741-xiao/stm32f407-dual-board-ai/方案设计.md

# 实验七 · 技术方案设计（v1）

> 依据：《需求确认.md v1.0》（题0/1/2/3 验收条款已确认）。
> 一句话目标：**两块 STM32F407** —— 板1 采集并本地显示，经 **CAN** 广播给板2（双屏显示 + **两板都呼吸灯**）；
> 两块板各自把本板 5 项数据经 **WiFi** 上报 PC，入库 MySQL，**网页 2 页**呈现；
> 再用 **CUBE-AI 神经网络**（跑在 STM32 上）判定"这条数据来自哪块板"。
>
> **姓名：郑鑫　　学号：202440700111**
>
> 当前状态：`firmware/` 为实验六工程拷贝，Keil Target 已收敛为 **board1/board2**（两 Target 0E0W）。
> 本方案描述从实验六到实验七的完整改造路径，其中 **§7 神经网络是本实验的主体新增**。

---

## 1. 总体策略

| 层 | 策略 | 理由 |
|---|---|---|
| 工程 | **独立仓库 `Lab7/`**，从实验六拷贝，收敛为两块板 | 实验六保持原样可交付，两者互不干扰 |
| 应用层 | 沿用一份共享实现（`app_node.c`），差异用 `BOARD_SEL`(1/2) 分叉 | 两块板硬件相同、功能高度重合 |
| 板间层 | **沿用 CAN1**（板1 广播数据/控制 → 板2 收） | 题目指定 can/485，CAN 实验六已跑通 |
| 网络层 | 两块板**都是 TCP client** → PC:8080 | 板间数据由 CAN 承担，WiFi 只上报 PC |
| 协议 | WiFi 侧升级 **v7**：D 帧追加 AI 判定字段；新增 **S 状态帧**（采集启停） | 题1 要求网页显示"采集开始/停止"；题2 要在页面显示 AI 结果 |
| PC 端 | 单文件上位机 → **拆成 2 页**（列表页 / 图形页） | 题1 明确"分 2 页" |
| 数据库 | `stm32_lab` 库新建 **`lab7_data`** 表 | 与实验四/五/六 数据互不干扰 |
| **AI** | **PC 训练（Keras）→ X-CUBE-AI 转 C → 板上推理** | 贴题给定路线（CSDN 那篇的操作方法） |

---

## 2. 系统拓扑

```
              PC（移动热点 192.168.137.1）
              ├── 上位机 TCP:8080（收两块板）
              ├── MySQL  stm32_lab.lab7_data
              └── 网页 2 页：① 记录列表（分页）  ② 图形（多风格）
      ▲                        ▲
      │WiFi client              │WiFi client
 ┌────┴────┐              ┌────┴────┐
 │  板1    │              │  板2    │
 │ 主控    │              │ 从节点  │
 │ +AI推理 │              │ +AI推理 │
 └────┬────┘              └────┬────┘
      └──── CAN 总线（双绞线，两端 120Ω）────┘
        板1 广播数据/控制 → 板2 接收
        板2 回传本板原始值 → 板1 做 AI 交叉验证（§7.6）
```

- **CAN**：两节点挂一对差分线（CANH/CANL），两端 120Ω，**必须共地**。
- **WiFi**：两块板各自 STA 连 PC 热点，静态 IP `192.168.137.51`（板1）/ `.50`（板2）。
- **两网分离**：板间走 CAN、上报走 WiFi，互不耦合。

---

## 3. CAN 通信设计

### 3.1 物理层与配置

| 项 | 取值 | 说明 |
|---|---|---|
| 外设 | **CAN1**（F407 原生） | 由 CubeMX 生成 `Core/Src/can.c`（MX_CAN1_Init / hcan1） |
| 引脚 | **PA11 = CAN1_RX，PA12 = CAN1_TX**（AF9） | ★ **不能用 PD0/PD1**（被 FSMC 占用，是 LCD 数据线 D2/D3） |
| 速率 | **500 kbps** | Prescaler=6、Seg1=10 tq、Seg2=3 tq（APB1=42MHz） |
| 帧格式 | 标准帧（11 位 ID），DLC ≤ 8 | 两节点广播，无需扩展帧 |
| 收发器 | 板载 **TJA1050**（U9） | 见 `docs/硬件核对-原理图.md` |
| 收发方式 | FIFO0 + 轮询（不加中断） | 1Hz 数据率，`CanTask` 每 10ms 取帧足够 |

> ★★ **上板前必做**：短接 **P21**（2×3 排针）的 **3–5 和 4–6**。
> PA11/PA12 与 USB 座共用，P21 是 USB/CAN 二选一。不跳 =
> 程序全对但**总线上毫无波形**（最容易被误判成"程序坏了"）。
> ★ 不要再外接 120Ω：每板自带一个（R35），两块板并联 ≈60Ω，短母线正合适。

### 3.2 报文定义

| ID | 名称 | 方向 | DLC | 载荷（大端） | 周期 |
|---|---|---|---|---|---|
| `0x100` | **DATA_A** | 板1→板2 | 8 | `seq(2) t10(2) h10(2) light(2)` | 1 Hz |
| `0x101` | **DATA_B** | 板1→板2 | 8 | `eco2(2) tvoc(2) status(1) board(1) rsv(2)` | 1 Hz |
| `0x200` | **CTRL** | 板1→板2 | 1 | `0x01=START / 0x00=STOP` | 事件 |
| `0x180` | **HEARTBEAT** | 双向 | 1 | `board` | 1 Hz |
| `0x110` | **PEER_A** | **板2→板1** | 8 | `seq(2) t10(2) h10(2) light(2)` | 1 Hz |
| `0x111` | **PEER_B** | **板2→板1** | 8 | `eco2(2) tvoc(2) status(1) board(1) rsv(2)` | 1 Hz |

- **量纲**：`t10/h10` = ×10 有符号（可负温）；`light` 0..4095；`eco2` ppm；`tvoc` ppb；`status` `1=OK/0=ALM`。
- **★ 新增 `0x110/0x111`（板2 → 板1）**：实验六是单向广播（板1 只发、板2/3 只收）。
  实验七题2 要做 **AI 交叉验证**（§7.6）—— 板1 必须拿到**板2 的原始 5 项值**，
  才能用自己那份模型去判"这条数据来自哪块板"。因此增加反向数据帧，**只加收，不改原有语义**。
- **在线判定**：板2 若 3s 未收到任一 `0x1xx` → 判板1 离线（「板1 区」占位"未连接"）；
  板1 若 3s 未收到 `0x180` 心跳 → 判板2 离线（状态页 `SLAVE2` 显示 NO）。

> 为什么数据拆两帧：5 项数值（2+2+2+2+2=10 字节）超过 CAN 单帧 8 字节上限，
> 按"序号+温湿光 / CO2+TVOC+状态"拆最清晰。

### 3.3 CAN 驱动接口（`USER/CAN/can_link.c`）

```c
u8   Can_Init(void);                       /* 配滤波器 + 进 Normal（★ 内部不调 HAL_CAN_Start，见下） */
u8   Can_SendData(s16 t10, s16 h10, u16 light, u16 eco2, u16 tvoc,
                  u16 seq, u8 ok, u8 board);          /* 按 board 自动选 0x100/0x101 或 0x110/0x111 */
u8   Can_SendCtrl(u8 start);                          /* 1=START / 0=STOP */
u8   Can_SendHeartbeat(u8 board);
u8   Can_Recv(can_msg_t *out);                        /* 非阻塞取一帧（FIFO0），1=取到 */
```

> ★★ **`Can_Init()` 故意不调 `HAL_CAN_Start()`**：它内部 `while` 等 INAK 清零，
> 唯一出口是 `HAL_GetTick()` 超时；本工程 HAL 时基从 SysTick 挪到了 TIM6，
> 而 `uwTick` 在那种场景下不涨 ⇒ **死循环**（实验六板2 白屏的根因）。
> 现在直接清 `INRQ` + 置 `LISTENING`，硬件同步上总线后自动进 Normal。

---

## 4. 网络方案与协议 v7

### 4.1 拓扑与 IP

| 节点 | 角色 | 静态 IP | 目标 |
|---|---|---|---|
| 板1 | STA / client | `192.168.137.51` | TCP → PC:8080 |
| 板2 | STA / client | `192.168.137.50` | TCP → PC:8080 |

- 两块板 AT 流程一致：`CWMODE=1 → CWJAP → CIPSTA=静态IP → CIPMUX=1 → CIPSTART=0,TCP,PC,8080 → READY`
- **断线重连**（实验六已修定，沿用）：三条通路 ——
  ① 模块吐 `0,CLOSED` → 标记 + 单发 `AT+CIPSTART`；② `CIPSEND` 失败兜底（半开连接）；
  ③ 周期补连（开机时 PC 没开）。PC 补连间隔 **5s**（`PC_RETRY_MS = LINK_RETRY_MS`）。
- ★ 补连成功回 READY 时**必须 `px_reset()`**（三处复位点要齐，否则 `+IPD` 状态机吃帧）。

### 4.2 协议 v7（WiFi 侧，相对实验六 v6 的变化）

| 类型 | v6（实验六） | v7（实验七） | 方向 |
|---|---|---|---|
| H 握手 | `H,<名>,<学号>,<board>` | 不变（★ **板号在最后一个字段**） | 板→PC |
| D 数据 | `D,<board>,<up_ms>,<seq>,<t>,<h>,<light>,<eco2>,<tvoc>,<OK/ALM>` | **追加 AI 判定**：`...,<ai_cls>,<ai_conf>` | 板→PC |
| **S 状态** | — | **新增** `S,<board>,START/STOP` | **板→PC** |
| — | （C 控制帧在实验六已删除） | 板间控制走 CAN，PC 仍不控制板 | — |

示例：

```
D,2,123456,0007,26.1,58.2,3210,512,23,OK,2,96      ← AI 判为板2，置信度 96%
S,1,START                                          ← 板1 开始采集
S,1,STOP                                           ← 板1 停止采集
```

- `ai_cls`：0 = 未推理 / 1 = 判为板1 / 2 = 判为板2
- `ai_conf`：0..100（百分比，四舍五入）
- **S 帧发送时机**：`running` 状态**发生变化**时立刻发一次（外加首次连上补发一次当前状态），
  保证网页打开时就能看到当前是"采集开始"还是"停止"。

### 4.3 空口流量预算

| | 实验六（三板） | 实验七（两板） |
|---|---|---|
| 每板发送 | 1 帧/s（D 帧 → PC） | 1 帧/s（D 帧）+ 偶发 S 帧 |
| 合计 | ~3 帧/s | **~2 帧/s** |

实验五实测单模块约 2 帧/s 时负载 20~60%。**2 帧/s 总负载更低，1Hz 采样安全**。

---

## 5. 固件设计

### 5.1 相对实验六的改动点

| 文件 | 动作 | 说明 |
|---|---|---|
| `USER/LED/led_effect.c` | **改** | ★ **板1 从流水灯改为呼吸灯**（题1："两板 LED 灯进行呼吸灯功能"）—— 两板统一走 TIM7 软 PWM |
| `USER/App/app_node.c` | 改 | ① 采集启停变化时发 **S 帧**给 PC；② 两板收敛（去掉 板3 相关显示/在线逻辑）；③ AI 推理任务与判定字段 |
| `USER/CAN/can_link.c/.h` | 改 | 新增 `0x110/0x111`（板2→板1）收发；`Can_SendData` 按 board 选 ID |
| `USER/AI/` | **新增** | X-CUBE-AI 生成的模型代码（`ai_*.c/.h`、`*-data-*` 权重表）+ 一层薄封装 `ai_model.c/.h` |
| `tools/make_project.py` | 改 | `USER_FILES` 挂入 AI 源文件；`USER_INC` 加 `../USER/AI` |
| `pc/upper_computer.py` | 改 | 拆 2 页；解析 S 帧与 AI 字段；入库加 ai 两列 |
| `pc/init_db.sql` | 改 | 新建 `lab7_data` 表 |

### 5.2 任务划分（两块板相同）

| 任务 | 优先级 | 周期 | 独占资源 | 职责 |
|---|---|---|---|---|
| `KeyTask` | 5 | 10ms | PF6~9 | 扫描按键（板1 作主控；板2 仅调试） |
| `SensorTask` | 4 | 1s | I2C1(SHT30)+I2C2(SGP30)+ADC1 | 采集 5 项 → 状态 + 样本队列 |
| `CanTask` | 3 | 10ms | CAN1 | 板1：广播数据/控制 + 收板2 回传；板2：收帧解析 + 回传本板值 |
| `WifiTask` | 3 | 5ms | UART4 | 推状态机 + 出队 → 组 D/S 帧 → 上报 PC |
| `AiTask` | **2** | 1s | （只读状态 + 少量 CPU） | **读最新样本 → 归一化 → `ai_run()` → 写判定结果** |
| `LedTask` | 2 | 20ms | LED 效果状态 | 推呼吸亮度 |
| `DisplayTask` | 2 | 200ms | FSMC(LCD) | 读状态刷屏 |
| `DebugTask` | 1 | 20ms | USART1 | 串口命令台（含 AI 判定打印） |

> `AiTask` 单独建一个任务（而不是塞进 `SensorTask`）的理由：推理有确定的最坏耗时，
> 放在采集任务里会把 1Hz 采样周期的抖动放大；单独建任务可独立测量耗时、独立降频。

### 5.3 按键 → 行为联动表

| 事件 | 板1 动作 | CAN 报文 | 板2 收到后 | 上报 PC |
|---|---|---|---|---|
| **板1 KEY0（按键1）** | `running=1`，开始采集 | `0x200 [0x01]` | 「板1区」开 → 呼吸灯开 | **`S,1,START`** |
| **板1 KEY1（按键2）** | `running=0`，报警解除 | `0x200 [0x00]` | 「板1区」清空 + 呼吸灯灭 | **`S,1,STOP`** |
| 板1 采集周期 | 出队样本 → D 帧上报 | `0x100+0x101`（1Hz） | 更新「板1区」数值 | D 帧 |
| **板2 上电** | 自动 `running=1`（上电即采） | `0x110+0x111`（1Hz 回传） | 显示本板区 | D 帧 + `S,2,START` |
| 板1 KEY2 / KEY3 | 切显示页 / 手动重发 CAN 快照 | — | 同左（KEY3 改为恢复 I2C） | — |

### 5.4 LED 效果（★ 相对实验六的改动）

| 板 | 实验六 | 实验七 |
|---|---|---|
| 板1 | 流水灯（三灯轮转 300ms） | **呼吸灯**（三灯同步，TIM7 软 PWM） |
| 板2 | 呼吸灯 | 呼吸灯（不变） |

- 触发：板1 = `running`（本板采集开关）；板2 = 收到 CAN `CTRL START`。
- **上电初始不亮**（实验六已如此）：符合"按板1按键1 才点亮两板 LED"的验收口径。

### 5.5 LCD 布局（沿用实验六，行距 28）

- **板1**：本板 5 项 + 序号/状态 + CAN 在线 + 底栏（WiFi/消息/按键提示）
- **板2**：本行 0 =「本板」小标题，数据在行 1..5；行 6..11 = 「板1区」+ 状态
- ★ **行号纪律**：本板 5 项数据的首行必须用 `OWN_ROW0` 宏（板1 → 0，板2 → 1），
  曾写死 0..4 导致从机页整列数值上移一行。
- ★ **擦除纪律**：静态骨架只画不擦；擦除只发生在动态字段自己的矩形内，
  且按**最宽的那个内容**先擦后画（同一位子轮换 `--` / 数值 / `关闭` 时）。

---

## 6. PC 上位机设计（2 页）

### 6.1 接收侧

- TCP 8080 收**两条连接**（板1/2），一连接一线程；身份靠 H/D/S 帧的 board 字段识别。
- 每块板各自标定 `offset`，换算 `sample_time`。
- 入库带 `board + 5 项 + ai_cls + ai_conf`；无口令/无 pymysql 时降级（只收不发库）。
- ★ **H 帧板号在最后一个字段**（`p[3]`）；D/S 帧板号在 `p[1]`。

### 6.2 页面结构（题1 明确"分 2 页"）

| 页面 | 路径 | 内容 |
|---|---|---|
| **① 记录列表页** | `/` | 状态条（**采集进行中 / 已停止**，由 S 帧驱动）+ 实时列表 + **分页**（首/上/下/末页、每页条数可选）+ 筛选/排序/编辑/删除/导出 CSV |
| **② 图形页** | `/chart` | **不同风格的图**：折线 / 柱状 / 面积（+ 散点或饼图凑"多种风格"），每图区分板1/板2 |

- 两页顶部**互相导航**（列表页 ↔ 图形页）。
- 「区分两板与采集时间」：列表每行标注**板号徽标**（板1 蓝 `#378ADD` / 板2 橙 `#EF9F27`，沿用实验六配色）与**采集时间**（毫秒精度）。
- 「显示采集开始/停止」：状态条由最新 S 帧决定；**超时兜底**（比如 10s 没收到该板任何帧 → 显示"离线"）。

### 6.3 MySQL 新表（`pc/init_db.sql`）

```sql
CREATE TABLE IF NOT EXISTS lab7_data (
    id          BIGINT UNSIGNED   NOT NULL AUTO_INCREMENT PRIMARY KEY,
    board       TINYINT UNSIGNED  NOT NULL COMMENT '1=板1，2=板2',
    seq         INT UNSIGNED      NULL,
    temp        DECIMAL(4,1)      NULL COMMENT '温度 ℃',
    humi        DECIMAL(4,1)      NULL COMMENT '湿度 %RH',
    light       SMALLINT UNSIGNED NULL COMMENT '光敏 AO 原始值 0..4095',
    eco2        INT UNSIGNED      NULL COMMENT 'SGP30 eCO2，ppm',
    tvoc        INT UNSIGNED      NULL COMMENT 'SGP30 TVOC，ppb（教材作"甲醛"指标）',
    status      VARCHAR(8)        NULL COMMENT 'OK / ALM',
    ai_cls      TINYINT UNSIGNED  NULL COMMENT 'AI 判定：0=未推理 1=板1 2=板2',
    ai_conf     TINYINT UNSIGNED  NULL COMMENT 'AI 置信度 0..100',
    up_ms       INT UNSIGNED      NULL COMMENT '该板 up_ms',
    sample_time DATETIME(3)       NULL COMMENT '采集时间（PC 换算）',
    recv_time   DATETIME(3)       NULL COMMENT 'PC 接收时间',
    KEY idx_board_sample (board, sample_time)
) ENGINE=InnoDB DEFAULT CHARSET=utf8mb4 COLLATE=utf8mb4_unicode_ci
  COMMENT='实验七 两板 温湿度+光敏+eCO2+TVOC + AI判定';
```

---

## 7. 神经网络方案（★ 本实验主体新增）

### 7.1 任务定义

| 项 | 取值 |
|---|---|
| 输入 | 5 维：`temp(℃) / humi(%RH) / light(0..4095) / eco2(ppm) / tvoc(ppb)` |
| 输出 | **2 分类**：`板1` / `板2`（softmax 两个概率） |
| 训练数据 | 两板**各 ≥ 100 条**已入库记录（题2 明确"至少各 100 条以上"） |
| 推理位置 | **STM32 板上**（X-CUBE-AI 生成的 C，`ai_run()`） |
| 题面"哪个传感器" | 落为**主导传感器特征**：给出各输入通道对判定的贡献（见 §7.5），串口/页面一并显示 |

> **为什么不做"10 类（板号×传感器）"**：一条记录本来就是 5 个传感器**同时**采的，
> "是哪个传感器采集数据"无法构成互斥标签。已确认按"判板号 + 输出主导特征"落地
> （见《需求确认.md》第六节决定 2）。

### 7.2 ★ 前置：可分性检验（决定题2 成败，务必先做）

**风险**：两板放同一张桌子上时，同型号传感器读数分布几乎重合，
神经网络只能学到比值 ≈ 随机 —— 训完才发现就晚了。

**做法**：采集完成后先跑 `tools/check_separability.py`：

1. 两板各 ≥100 条 → 合并成带 `board` 标签的数据集；
2. **5 折交叉验证**（用轻量分类器，如逻辑回归/随机森林）给出准确率；
3. **通道分布对比**：逐通道画两板的直方图 / 箱线图，看差异落在哪个通道；
4. **PCA / 二维投影散点图**：直观看出两簇是否分离；
5. 输出结论：**准确率 ≥ 80% 视为可分**，可以进入训练；否则先调整摆放重采。

**"制造可分性"的合规做法**（不是造假，是让两板处于可区分的真实工况）：

- 板1 放在**常温区**（如桌面），板2 放在**另一处**（靠窗 / 靠散热口 / 用手捂或遮光）；
- 让两板的**光照条件**不同（一块朝窗、一块背光）—— 光敏通道差异最显著；
- 让两板附近**CO₂/TVOC 环境**不同（一块靠近人呼吸方向）—— SGP30 通道差异；
- 另外每片传感器本身有**器件个体偏差**与 ADC 通道偏移，这部分差异是稳定的、可学的。

> 检验脚本会把"哪些通道在起区分作用"直接打印出来，正好作为 §7.5
> "主导传感器特征"的**物理解释依据**，一举两得。

### 7.3 训练流程（`tools/train_nn.py`）

```
MySQL lab7_data
   ↓ 导出 CSV（仅取 status='OK' 的行，剔除预热期与异常值）
特征工程
   ↓ z-score 标准化：mean/std 由训练集算出，★ 并存成 .h 供固件复用
模型（小 MLP，够小才塞得进 F407）
   ↓ 5 → 16 (ReLU) → 16 (ReLU) → 2 (Softmax)
训练
   ↓ Adam，交叉熵，batch 16，早停（验证集）；训练:验证 = 8:2，分层抽样
评估
   ↓ 混淆矩阵 / 准确率 / 每类精确率召回率
导出
   ↓ 保存 model.keras（或 .h5）
X-CUBE-AI
   ↓ analyze → generate（生成 C 代码 + 内存报告）
固件
   ↓ ai_<model>_create / init / run
```

**参数量估算**（决定 F407 是否吃得下）：

| 层 | 参数 |
|---|---|
| 5 → 16 | 5×16 + 16 = 96 |
| 16 → 16 | 16×16 + 16 = 272 |
| 16 → 2 | 16×2 + 2 = 34 |
| **合计** | **402 参数** ≈ 1.6 KB（float32） |

F407 带**单精度 FPU**，这个规模即使不量化也毫无压力；
若想演示量化收益，可另跑一次 int8（体积 ~0.4 KB，但需注意输入量化）。

> ★ **归一化必须一致**：板上推理时要用**训练时同一套 mean/std**。
> 所以训练脚本除了模型，还要导出 `ai_norm.h`（5 个 mean + 5 个 std），
> 固件里在喂给 `ai_run()` 之前做同样的 z-score。
> 这是"PC 训练 / 板上推理"最容易出错的一环 —— 忘了这步会得到完全离谱的判定。

### 7.4 集成进 Keil 工程

| 步骤 | 做法 |
|---|---|
| 1 | 用户先完成**题0**：CubeMX 里装好 X-CUBE-AI（ST 账号登录 → [STMicroelectronics] → [X-CUBE-AI] → Install） |
| 2 | 用 X-CUBE-AI 分析 `model.keras`（CubeMX 图形界面，或 `stm32ai analyze`） |
| 3 | 生成 C 代码（一般落在 `firmware/X-CUBE-AI/App/` 或指定目录），把生成物搬进 `firmware/USER/AI/` |
| 4 | 跑 `python tools/make_project.py firmware` 重新挂文件 + include 路径（**不要手工改 XML**） |
| 5 | 两 Target 编译 0E0W，检查 Flash/RAM 增量（`Program Size` 行 + X-CUBE-AI 的内存报告） |

> ★ CubeMX 重新生成工程后**必做两件事**：① 跑 `make_project.py`（恢复 USER 组与两个 Target）；
> ② 确认 startup 的 `Stack_Size` 仍是 `0x1000`。

### 7.5 「主导传感器特征」怎么给

三种做法，按实现成本递增（先做第 1 种，够用即可）：

1. **单通道扰动法（最直接）**：把一条样本的某个通道替换成另一板的均值，看输出概率变化多少。
   变化越大 → 该通道越"主导"。5 个通道各做一次，取 Top-2 显示。
2. **输入梯度 / 显著性**：\|∂输出/∂输入\| 归一化后排序（板上算成本高，适合 PC 侧算完展示）。
3. **消融重训**：逐个通道去掉重训，看准确率掉多少（慢，但最有说服力，可放文档里当补充实验）。

> 落地产出：串口/页面显示形如
> `AI 判定: 板2 (96%)  主导特征: light, eco2`
> —— 这既回应了题面"是哪个传感器采集数据"，也解释了模型到底靠什么在做判别。

### 7.6 ★ CAN 交叉验证演示（题2 的亮点闭环）

```
板2 采集本板 5 项
   ↓ CAN 0x110 / 0x111（板2 → 板1）
板1 收到"对板原始值"
   ↓ 用板1 自己那份模型 + 同一套归一化参数 → ai_run()
板1 判定：这条数据来自 板2  ✔（串口 + 网页显示）
```

- 对照组：板1 拿**自己**的数据推理，应判为**板1**。
- 这样"AI 判来源"就不是纸面指标，而是**能当场演示**的闭环，且完全复用实验六那条 CAN 链路。
- 演示顺序（录进 KK 录像）：① 板1 判自己 → 板1；② 板1 判 CAN 传来的板2 数据 → 板2；
  ③ 网页上同时可见两板的 AI 判定与置信度。

---

## 8. 实施阶段计划（里程碑）

| 阶段 | 内容 | 验证方式 | 状态 |
|---|---|---|---|
| **0** | 骨架（实验六拷贝 + 两 Target 收敛）+ 需求确认 + 本方案 | 两 Target 0E0W；文档提交 | ✅ 已完成 |
| 1 | 题1 改造：板1 呼吸灯；采集启停上报 PC（S 帧） | 上板看两板呼吸；网页状态条随按键变化 | ⬜ |
| 2 | 题1 改造：上位机拆 2 页 + MySQL 真跑通（`lab7_data`） | 两页可导航；库中数据可查 | ⬜ |
| 3 | 题2 数据采集：两板各 ≥100 条 | `check_separability.py` 输出可分性结论 | ⬜ |
| 4 | 题2 训练 + X-CUBE-AI 转换 + 集成 | 模型报告（准确率/Flash/RAM）；两 Target 0E0W | ⬜ |
| 5 | 题2 板上推理 + 串口/页面上报 + CAN 交叉验证 | 任取 10 条，串口逐条输出判定与对错 | ⬜ |
| 6 | 题3 文档（≥3 页含截图）+ KK 录像 | 照 §9 验收脚本逐条走 | ⬜ |
| 7 | 全链路验收 | 对照《需求确认.md》A/B/C/D/G/H 逐条 | ⬜ |

> 实施纪律（沿用实验五/六）：每步"改动 → 编译 0E0W → 上板 → git commit（message 中文带阶段号）"。
> `Core/` 下 CubeMX 生成代码不手改（CAN 初始化属手写例外，已加注释说明）。

---

## 9. 风险与备选

| # | 风险 | 缓解 | 备选 |
|---|---|---|---|
| 1 | **两板数据不可分**（题2 最大风险） | §7.2 先做可分性检验；按需调整两板摆放制造稳定差异 | 加大环境差异（热源/遮光/CO₂ 源）；或增加派生特征 |
| 2 | X-CUBE-AI 未安装 / 装不上 | 题0 需 ST 账号联网安装；提前确认 CubeMX ≥6.9 | 用 `stm32ai` 命令行单独生成 |
| 3 | CubeMX 重新生成把 Target 改名 | 生成后必跑 `make_project.py`（恢复 USER 组 + board1/2） | 保留 `firmware.uvprojx.pre_make.bak` 回溯 |
| 4 | AI 代码吃 Flash/RAM | 模型仅 402 参数（≈1.6KB）；X-CUBE-AI 会先给内存报告 | int8 量化；或缩小隐藏层 |
| 5 | **归一化参数不一致**导致板上判定离谱 | 训练脚本一并导出 `ai_norm.h`（mean/std），固件用同一套 | 干脆把归一化写进模型第一层（X-CUBE-AI 支持把归一化烘焙进网络） |
| 6 | CAN 没跳 P21 跳线 → 总线上无波形 | 上板清单里列为**必做项**，先量波形再查程序 | 用示波器看 PA12 是否有发送沿 |
| 7 | MySQL 口令/编码问题 | `pc/db_local.py` 本地私有（不入库），用 `utf8mb4` | 降级为只收不发库（不影响网页演示） |
| 8 | 单模块 2 帧/s 负荷 | 两块板各 1 帧/s，预算比实验六更宽 | 降采样到 0.5Hz |

---

## 10. git 版本管理

- 仓库：`E:/Develop/SignalsAndSystems/Lab7/`（**独立仓库**）。
- `.gitignore` 沿用实验六，并新增 AI 中间产物（`ai/dataset/*.csv`、`ai/model/*.h5|.keras|.tflite`）不入库
  —— 模型和数据都能用脚本重建，只把**生成它们的脚本**入库。
- 提交规划：① 初始骨架（实验六拷贝 + 两 Target）→ ② 需求确认 + 方案设计 → 后续每阶段一次提交，message 中文带阶段号。
