741-xiao/stm32f407-dual-board-ai/需求确认.md

# 实验七 · 需求确认（v1.0）

> 把题目原文整理为"可验收条款"，作为开发与验收基线。
> 2026-10-12 就 7 项关键问题达成确认（见第六节）。
>
> **姓名：郑鑫　　学号：202440700111**（各题交付物均需署名，见 `docs/` 内文档首页）

---

## 一、原始需求（题目原话）

**题 0（环境准备）**
> 在 stm32cubemx 安装好 x-cube-ai，stm32cubemx 版本至少 6.9 以上，并利用 st 账号登录，在 [STMicroelectronics] 标签页下找到 [X-CUBE-AI]，勾选需要的 Artificial Intelligence 版本，点 [Install]，按提示完成安装即可。

**题 1（两板采集 → 双屏显示 → 上传入库 → 网页显示）**
> 利用两块 STM32F407 开发板，通过 can 或 485 进行控制连接，在板1按键1将两板温湿度 SHT30、光敏、co2 甲醛传感器分别显示在各自 OLED 上，同时利用 wifi 上传到 PC 机 mysql 数据库中保存，利用 python 或 java 分 2 页完成动态列表分页显示记录和不同风格的图形，注意区分两板与采集时间，两板 LED 灯进行呼吸灯功能，板1按键2将停止采集，LED 灯停止，web 页面显示采集开始或停止。

**题 2（神经网络）**
> 对题1采集的两板传感器数据记录，至少各 100 条以上，利用 https://qingsong.blog.csdn.net/article/details/130823175 （我在STM32单片机上跑神经网络算法—CUBE-AI）操作方法，利用神经网络方法进行训练，在后续采集的数据中进行检测，任取10条记录，能否在串口/页面中判定是哪个开发板数据，是哪个传感器采集数据？

**题 3（交付物）**
> 将题2操作过程分别用文档与用 KK 录像机完整录相，不超过5分钟，解说口齿清晰、准确、图像清晰，文档要有截图，不少于3页。每个题均要有姓名与学号。

---

## 二、需求拆解 → 验收条款

### 题 0 · 环境

| # | 条件 | 验收点 |
|---|---|---|
| 0-1 | CubeMX 版本 | ≥ 6.9（本机为 6.18.1 ✅） |
| 0-2 | 安装 X-CUBE-AI | ST 账号登录 → [STMicroelectronics] → [X-CUBE-AI] → 勾选版本 → Install 成功 |
| 0-3 | 可用性 | 能在工程里看到 `X-CUBE-AI` 分类，并能生成 AI 代码（`ai_*` 源文件 + 报告） |

### 题 1 · 两块板 CAN 互联 + 双屏显示 + WiFi→MySQL + 2 页网页 + 呼吸灯 + 启停

**A 采集与显示（两块板都要）**

| # | 操作 / 条件 | 预期结果（验收点） |
|---|---|---|
| A1 | 按 **板1 按键1**（KEY0） | **两板同时开始采集**本板 SHT30 温湿度 + 光敏 + SGP30(eCO₂/TVOC) 共 5 项 |
| A2 | 采集期间（1 次/秒） | 两板屏幕各自动态刷新 **本板 5 项**数据 + 序号 + 状态 |
| A3 | 采集期间 | 板1 经 **CAN** 广播数据帧 |
| A4 | 采集期间 | **板2 屏幕「板1 区」同步动态显示板1 的 5 项数据**（"两板数据分别显示在各自屏上"） |
| A5 | **上电** | ★ 两块板**都不采**（对称）；按 **任意一板的 KEY0** 才一起开始 |
| A6 | 按 **任意一板的 KEY1** | 两块板**同时停止**采集；两板 LED 灭；板2「板1 区」全关闭 |

**B 两板呼吸灯**

| # | 操作 / 条件 | 预期结果（验收点） |
|---|---|---|
| B1 | 采集期间 | **板1 与 板2 的 LED 都呈现呼吸灯效果**（明暗渐变循环） |
| B2 | 按板1 按键2 | 两板 LED 呼吸**停止**（全灭） |
| B3 | 上电未采集时 | 两板 LED 均不亮（由上电状态决定，非"上电即呼吸"） |

**C WiFi 上报 → MySQL 入库**

| # | 需求 | 验收点 |
|---|---|---|
| C1 | 两板各经 WiFi 连 PC 热点 | 两板均实时到达 PC（`192.168.137.51` / `.50` → PC `192.168.137.1:8080`） |
| C2 | 入库 | 数据写入 MySQL，**区分板号**（`board` 列）**与采集时间**（`sample_time`），另存 PC 接收时间（`recv_time`） |
| C3 | 数据量 | 两板**各 ≥ 100 条**有效记录（题2 的训练前提，见 G1） |

**D Web 页面（2 页）**

| # | 需求 | 验收点 |
|---|---|---|
| D1 | 分 2 页 | 网站至少 **2 个页面**，可互相导航：**① 记录列表页（动态列表分页）　② 图形页（不同风格的图）** |
| D2 | 动态列表分页 | 列表**分页**显示（每页 N 条，首/上/下/末页可切换），新数据实时进入列表 |
| D3 | 区分两板与采集时间 | 每行标注 **板号** 与 **采集时间**（两板用不同颜色标识） |
| D4 | 不同风格的图形 | 同一数据用**多种互不重复的图形风格**呈现（折线 / 柱状 / 面积 …），并区分两块板 |
| D5 | **显示采集开始 / 停止** | 网页上能看出当前是**采集开始**还是**停止**（由板1 按键1/按键2 驱动，实时变化） |
| D6 | 语言 | Python 或 Java（沿用实验五/六 的 Python 单文件零依赖方案） |

### 题 2 · 神经网络（CUBE-AI）

| # | 需求 | 验收点 |
|---|---|---|
| G1 | 数据 | 两板**各 ≥ 100 条**已入库记录（含 5 项特征：temp / humi / light / eco2 / tvoc） |
| G2 | 训练 | 用神经网络训练一个分类模型；给出**训练/验证准确率**与混淆矩阵 |
| G3 | 转换 | 经 **X-CUBE-AI** 把模型转成 STM32 可运行的 C 代码，集成进 Keil 工程 |
| G4 | 板端推理 | **在 STM32 上跑推理**（`ai_run()`），对采集到的记录给出判定 |
| G5 | 串口判定 | 串口打印判定结果；**任取 10 条记录**逐条输出"判定为哪块板 + 置信度 + 是否正确" |
| G6 | 页面判定 | 网页同步显示 AI 判定结果，可看出 10 条样本的对错 |
| G7 | 「哪个传感器」 | 见第六节决定 2：模型输出**主导传感器特征**（哪几个通道在起决定作用），在串口/页面一并显示 |
| G8 | 演示闭环 | 经 **CAN 交叉喂数据**：把对板原始传感器值传给本板，由本板 NN 判"这条数据来自哪块板" |

### 题 3 · 交付物

| # | 需求 | 验收点 |
|---|---|---|
| H1 | 文档 | 题2 操作过程文档，**≥ 3 页**，含**截图** |
| H2 | 录像 | 用 **KK 录像机**录制，**≤ 5 分钟**，解说口齿清晰、准确、图像清晰 |
| H3 | 署名 | **每个题（题0/1/2/3）均有姓名与学号** |

---

## 三、默认约定

- 采样周期 **1 秒/次**（ESP-01S 实测吞吐天花板 ≈1.5 次 CIPSEND/s）
- 按键（沿用实验六口径，**一律用板上网络名 KEY0..KEY3**）：
  **KEY0 = 开始采集 / KEY1 = 停止采集 / KEY2 = 切显示页 / KEY3 = 手动动作**
  - 题目里的"按键1 / 按键2"分别对应 **KEY0 / KEY1**（功能一一对应：开始 / 停止）
- 板间通信：**CAN1**（PA11/PA12，500 kbps）；WiFi：PC 开 2.4G 移动热点 `192.168.137.1`，两板均为 **STA（client）**
- 时间戳：帧内带上电毫秒 `up_ms`，PC 侧按每板各自的偏移换算采集时刻
- 工程结构：**一个 Keil 工程、两个 Target（board1 / board2）**，两块板共用一份源码（靠 `BOARD_SEL` 分叉）
- 调试串口 USART1 115200-8-N-1

---

## 四、与实验六的差异盘点（= 本次改造范围）

| 模块 | 实验六 现状 | 实验七 需改造为 |
|---|---|---|
| 板数 | 3 块（board1/2/3） | **2 块**（board1/2），Target 与工程量已收敛 ✅ |
| 板间通信 | CAN1 广播 | **不变** ✅ |
| 传感器 | SHT30 + 光敏 + SGP30（5 项） | **不变** ✅ |
| 显示 | 板1 数据页 5 项；板2/3 本板区 + 板1 区 | **不变** ✅（两板各自显示两板数据） |
| **LED** | 板1 流水灯 / 板2·3 呼吸灯 | ⚠️ **改**：**板1 也改呼吸灯**（两板一致） |
| **Web 采集启停** | ⚠️ C 帧只经 CAN 发从机，**未上报 PC** | **改**：启停状态同时上报 PC，网页可见 |
| **网页结构** | 单页（列表 + 5 风格图混排） | **改**：拆成 **2 页**（列表页 / 图形页） |
| **MySQL** | 代码具备但**未实跑** | **改**：真跑通，表改 `lab7_data` |
| **AI** | ❌ 无 | **新增**：X-CUBE-AI 神经网络，见题2 |
| 协议 | v6：`H / D / C` 帧 | **v7**：增加 AI 判定字段 + 采集状态上报（见 `方案设计.md` §4） |
| 数据库 | `lab6_data` | **`lab7_data`**（实验四/五/六 的表都不动） |

---

## 五、推荐技术方案（详见 `方案设计.md`）

1. **板间**：板1 周期性广播数据帧（`0x100`/`0x101`）+ 按键控制帧（`0x200`）+ 1Hz 心跳（`0x180`）
2. **网络**：两块板各自 TCP client → PC:8080；CAN 承担板间数据，WiFi 只负责上报 PC
3. **显示**：沿用 ILI9341（240×320）驱动与布局框架
4. **传感器**：SHT30 → I2C1（PB6/PB7）；SGP30 → I2C2（PF0/PF1）
5. **PC**：基于实验六单文件上位机改造 → 拆 2 页 + Python
6. **数据库**：沿用 `stm32_lab` 库，新建 **`lab7_data`** 表
7. **AI（本次核心）**：
   - PC 侧用 **Keras/TensorFlow** 训练一个小 MLP（输入 5 维 → 隐藏层 → 2 分类）
   - 经 **X-CUBE-AI** 转成 C 代码集成进 Keil 工程（定点/浮点按 F407 资源定）
   - 板端 `ai_run()` 推理 → 串口 + WiFi 上报判定结果
   - **训练前先做可分性检验**（见第六节决定 3），避免训出近似随机的模型

---

## 六、已确认决定（2026-10-12）

| # | 事项 | 决定 |
|---|---|---|
| 1 | 工程组织 | **新建 `Lab7/` 独立工程**，从实验六拷贝，收敛为两块板（实验六保持原样可交付） |
| 2 | 题2 分类目标 | **2 分类判板号**（板1 / 板2）；"哪个传感器"落为**输出主导传感器特征**（各通道重要性）。理由：一条记录本就是 5 个传感器同时采的，"哪个传感器采集数据"无法直接作分类标签 |
| 3 | 两板数据可分性 | **先采 100+ 条做可分性检验**，达标才训练；不达标先调整两板摆放（制造稳定差异）再重采 |
| 4 | 显示屏 | **2.8″ TFT LCD（ILI9341, 240×320）** —— 题目写的"OLED"按此实现，直接复用实验六驱动 |
| 5 | 板间通信 | **CAN**（题目写"can 或 485"，取 CAN，实验六已跑通） |
| 6 | 推理位置 | **板上推理**（贴题"在串口判定"）；配合 **CAN 交叉喂数据**做演示闭环 |
| 7 | 训练框架 | Keras/TensorFlow 训练 → X-CUBE-AI 转换（贴题给的 CSDN 教程路线） |
| 8 | **两板等价**（2026-10-12 追加） | ★ 按**任意一板**的 KEY0/KEY1 都能让**两板同时**开始/停止采集（CAN 控制帧改双向：板1 发 `0x200`、板2 发 `0x201`）；**上电两板都不采**（取消实验六的"从机上电即采"，否则"同时开始"无从谈起） |

---

## 七、开发计划

| 阶段 | 内容 | 状态 |
|---|---|---|
| 1 | 公共底座：工程拷贝、两 Target 收敛、文档 | ✅ 已完成 |
| 2 | 题1 改造：板1 呼吸灯；采集启停上报 PC | ✅ 已完成（`ec86240`） |
| 3 | 题1 改造：上位机拆 2 页 + MySQL 真跑通 | ✅ 代码完成（待真板+MySQL 实跑） |
| 4 | 题2：采集两板各 ≥100 条 + 可分性检验 | ✅ 已完成（852 条，可分性 1.000） |
| 5 | 题2：训练模型 + X-CUBE-AI 转换集成 | ✅ 已完成（852 条 · 可分性 1.000 · 训练/验证 1.0000；`model.onnx` → stedgeai 转 C → 集成后两 Target **0E0W**） |
| 6 | 题2：板端推理 + 串口/页面上报 + CAN 交叉验证 | ✅ 已完成 —— 上板实测 **200/201 = 99.50%**（唯一误判是开机首条 SGP30 预热样本）；串口 `n` 判定 10/10、网页「AI 判定」列、CAN `0x110/0x111` 闭环均已跑通 |
| 7 | 题3：文档（≥3 页含截图）+ KK 录像 | 🟡 正文已就绪：`docs/实验报告.md`（题0/1/2/3 每节均署名）+ `docs/录像脚本.md`（≤5min 逐镜头口播）；**待按附录 A 拍 S0~S17 截图**（存 `docs/shot/`）后转 Word |
| 8 | 全链路验收：对照第二节 A/B/C/D/G/H 逐条演示 | 🟡 验收脚本已定稿（`docs/验收演示脚本.md` §3~§4），待按 §5 拍完 S1~S14 留档 |

> ~~★★★ 演示前必做（当前最大风险）~~ → **已解决**：已按**演示摆放（两板相隔 10 cm）**
> 重新采集并训练（207 条，可分性 1.000）。实测 CO₂ 两板差由 459 降到 98（2.1σ），
> 「环境差」确实随距离消失，但**温度 49.5σ / 光敏 46.3σ 的器件个体差异**仍然可分。
> 另外上板实测 201 条独立验证 = **99.50%**，且用上一批次 210 条做**跨批次**验证 = 100%，
> 说明模型学到的是两板的稳定差异而非某一批数据的偶然特征。

> 题2 流水线（`ai/README.md` 有完整说明）：`export_dataset.py` → `check_separability.py`
> → `train_nn.py`，三步均已用模拟数据端到端跑通；真数据到手后换数据源即可。
