741-xiao/stm32f407-dual-board-ai/docs/录像脚本.md

# 实验七　KK 录像脚本（≤ 5 分钟）

**姓名：郑鑫　　学号：202440700111**

录制工具：**KK 录像机**（题目指定）。要求：不超过 5 分钟、解说口齿清晰、
图像清晰。下面按时间轴给了**每个镜头的画面 + 可直接照念的口播词**，练两遍再录。

> ★ 录之前先做 `docs/验收演示脚本.md` §8 的检查（阈值默认 35℃ 不用敲，**只有板1 有效**；
> 两个 hex 都是刚编译的、上位机已用 `STM32_DB_CLEAR=1` 清表重启）。
> ★ 开录前先按一次 KEY0 让两块板跑起来 15 秒再停 —— 避开 SGP30 的暖机期，
> 否则 CO₂/TVOC 会显示 400 / 0。

---

## 镜头表

### ⓪ 开场（0:00 ~ 0:20）

| | |
|---|---|
| **画面** | 两块板全景，能看清 CAN 双绞线、两块 LCD、两个 ESP-01S |
| **口播** | 「老师好，我是郑鑫，学号 202440700111。这是实验七，用两块 STM32F407 通过 CAN 总线互联，采集温湿度、光敏、二氧化碳和 TVOC，再通过 WiFi 上传到 PC 的数据库和网页，最后用神经网络判断数据来自哪一块板。」 |

### ① 接线与就绪（0:20 ~ 0:40）

| | |
|---|---|
| **画面** | 镜头推近 CAN 接口与 **P21 跳线**，再切到 PC 屏幕上已经打开的网页 |
| **口播** | 「两块板之间用 CAN 连接，速率 500k，板上 120 欧终端电阻，PA11、PA12 通过 P21 跳线接到收发器。PC 这边跑的是单文件上位机，TCP 8080 收数据，8000 端口提供两个网页。」 |

### ② 采集开始：两板同时（0:40 ~ 1:20）★ 重点

| | |
|---|---|
| **画面** | 手指按**板 1 的 KEY0** → 立刻把镜头并排对准两块屏（两块同时出数）→ 再拍两块板的 LED 呼吸 |
| **口播** | 「现在按任意一块板的 KEY0 开始采集。可以看到，**两块板同时**开始：各自的屏幕上显示本板的五个传感器值，板 2 的屏幕上还有一栏是板 1 区的数据，是板 1 通过 CAN 传过来的。两块板的 LED 也一起进入呼吸灯状态。」 |

### ③ 反向验证：按板 2 也能带动两板（1:20 ~ 1:35）

| | |
|---|---|
| **画面** | 先按板 2 的 KEY1 停 → 再按板 2 的 KEY0 开，镜头同时框住两块屏 |
| **口播** | 「按板 2 的按键同样可以控制两块板，两块板的行为完全等价。」 |

### ④ 网页两页（1:35 ~ 2:25）

| | |
|---|---|
| **画面** | 网页①（列表页）：滚动展示分页、板号颜色区分、采集时间、AI 判定列；再切到网页②（图形页）依次点 5 种风格 |
| **口播** | 「这是网页第一页，记录列表，做了分页显示，用颜色区分两块板，并且显示每一条的采集时间；这一列是板上神经网络的判定结果。第二页是图形显示，有折线、柱状、面积、饼图、散点五种风格。」 |

### ⑤ 数据库入库（2:25 ~ 2:45）

| | |
|---|---|
| **画面** | 数据库客户端里执行 `SELECT board, COUNT(*) FROM lab7_data GROUP BY board;` |
| **口播** | 「数据同时写入了 MySQL 的 lab7_data 表。按板号分组统计，两块板各 100 条以上，满足题目要求。」 |

### ⑥ 停止采集（2:45 ~ 3:00）

| | |
|---|---|
| **画面** | 按 KEY1 → 两板 LED 灭、屏幕停止刷新；切网页看状态条变成「已停止」 |
| **口播** | 「按 KEY1 停止采集，两块板同时停止，LED 熄灭，网页的状态条也从『采集进行中』变成『已停止』。」 |

### ⑦ 题 2 流程之一：可分性与训练（3:00 ~ 3:50）

| | |
|---|---|
| **画面** | 依次展示 `ai/report/separability.md`（逐通道表格）→ `sep_pca.png`（散点）→ `train_report.md`（准确率、混淆矩阵、通道重要性） |
| **口播** | 「进入题 2。训练之前先做了可分性检验：温度、光敏、湿度这三个通道两板差异明显，五个通道合起来做五折交叉验证准确率是 1.00，说明数据可分。模型是一个 5 到 16 到 16 到 2 的小型神经网络，只有 402 个参数，训练和验证准确率都是 1.0000。这里是各通道的重要性，温度和光敏起的作用最大。」 |

### ⑧ 题 2 流程之二：转 C 与编译（3:50 ~ 4:15）

| | |
|---|---|
| **画面** | `firmware/USER/AI/` 目录（7 个 network 文件）→ Keil 编译输出 `0 Error 0 Warning` |
| **口播** | 「用 X-CUBE-AI 的 stedgeai 工具把模型转换成 C 代码，一共七个文件，放进工程的 USER/AI 目录，编译两个目标都是零错误零警告，模型占用大约 9 KB 的 ROM。」 |

### ⑨ 题 2 结果：板上判定（4:15 ~ 4:45）★ 重点

| | |
|---|---|
| **画面** | 串口助手敲 `n`，逐行滚动 10 条判定（板号 + 置信度 + 是否正确）；然后切到网页看 AI 判定列 |
| **口播** | 「推理是在 STM32 上跑的。在串口敲 n，板子对预留的 10 条数据逐条判定，每条都给出判定为哪块板、置信度和是否正确，10 条全部正确。网页上也能看到同样的判定结果。实测 201 条数据，板上判对 200 条，准确率 99.5%，唯一一条错的是开机第一条，那时 SGP30 传感器还在预热，读数是固定值。」 |

### ⑩ CAN 交叉验证 + 收尾（4:45 ~ 5:00）

| | |
|---|---|
| **画面** | 板 1 屏幕特写：`OWN` / `PEER` 交替出现 |
| **口播** | 「最后做一个交叉验证：板 2 的原始数据通过 CAN 传给板 1，由板 1 自己的模型判断这条数据来自哪块板，屏幕上显示 OWN 表示判为本板、PEER 表示判为对板，证明模型判断的确实是数据的来源。以上是本次实验的全部内容，谢谢老师。」 |

---

## 时间预算

| 段落 | 时长 | 累计 |
|---|---|---|
| ⓪ 开场 | 0:20 | 0:20 |
| ① 接线与就绪 | 0:20 | 0:40 |
| ② 采集开始 | 0:40 | 1:20 |
| ③ 反向验证 | 0:15 | 1:35 |
| ④ 网页两页 | 0:50 | 2:25 |
| ⑤ 数据库 | 0:20 | 2:45 |
| ⑥ 停止采集 | 0:15 | 3:00 |
| ⑦ 可分性与训练 | 0:50 | 3:50 |
| ⑧ 转 C 与编译 | 0:25 | 4:15 |
| ⑨ 板上判定 | 0:30 | 4:45 |
| ⑩ 交叉验证与收尾 | 0:15 | **5:00** |

> 录完用播放器确认**总长 ≤ 5:00**；超了就压缩 ④ 和 ⑦ 的停顿，别删 ② 和 ⑨。

---

## 常见问题

| 情况 | 处理 |
|---|---|
| 网页一直不动 | 检查 PC 热点、两板 WiFi 是否连上（串口敲 `w` 看重连原因），以及防火墙是否放行 8080/8000 |
| 板 2 屏上「板 1 区」不刷新 | CAN 没通：查 P21 跳线、双绞线 A/B 是否接反 |
| CO₂/TVOC 显示 400 / 0 | SGP30 还在暖机，开录前先让板子跑 15 秒 |
| 判定忽然变成未推理 | 板子刚重启，等第一条上报即可；或检查是否烧的是最新 hex（`tools/check_sync.py --hex`） |
