741-xiao/stm32f407-dual-board-ai/docs/项目加载与答辩.md

# 实验七 · 项目加载使用 + 答辩问答

> **姓名：郑鑫　　学号：202440700111**
>
> 这份文档解决两件事：① 换一台电脑后，怎么把这个项目**打开、编译、烧写、跑起来**；
> ② 验收/答辩时老师**可能问什么**，以及怎么用项目里的真实数据回答。
>
> 配套文档：`README.md`（全流程）、`docs/验收演示脚本.md`（逐条验收）、`docs/实验报告.md`（题3 正文）。

---

## 0. 先背两段自述

**30 秒版**

> 这个实验用两块 STM32F407，通过 CAN 总线互联。任意一块板按 KEY0，两块板同时采集本板的
> 温度、湿度、光敏、eCO₂、TVOC，各自显示在 LCD 上，板 1 的数据通过 CAN 实时送到板 2 显示；
> 两块板各自用 WiFi 把数据上传到 PC 的 MySQL，网页分两页展示。
> 然后用采集到的数据训练一个小神经网络，用 X-CUBE-AI 转成 C 代码跑在 STM32 上，
> 判断一条数据来自哪块板。

**2 分钟版**（在上面基础上补 4 个数字）

> 采样 1 Hz，CAN 500 kbps；模型是 2→16→16→2 的 MLP，354 个参数、1.4 KB 权重；
> 训练/验证准确率 1.0000，留出的 10 条全部判对；
> 数据按演示摆放采集，避免"采集时一个环境、演示时另一个环境"。

---

## 1. 怎么加载、编译、烧写、跑起来

### 1.1 硬件（★ 三处最容易翻车）

| # | 事项 | 不做的后果 |
|---|---|---|
| 1 | **P21 跳线短接 3–5、4–6**（每板 2 个短路帽） | 程序全对，但 CAN 总线上**一点波形都没有** |
| 2 | **CANH↔CANH、CANL↔CANL，两板共地**；**不要再外接 120 Ω**（板载 R35） | 时通时断 / 总线电阻不对 |
| 3 | 两板**摆放 = 采集数据时的摆放**（约 10 cm，传感器朝向别动） | 数据分布变了，AI 判定可能当场翻车 |

传感器接线：SHT30 → I2C1（PB6/PB7，从 P18 摄像头座引）；SGP30 → I2C2（PF0/PF1）；
光敏 → ADC1_IN10（PC0，从 P19 引）；ESP-01S → UART4（PA0/PA1，CH_PD=PF14）。

### 1.2 Keil：打开工程 → 编译 → 烧写

工程文件：`firmware\MDK-ARM\firmware.uvprojx`（**一个工程、两个 Target**）。

```
① 双击 firmware\MDK-ARM\firmware.uvprojx
② Keil 工具栏 Target 下拉框选 board1 → F7 编译 → 下载（LOAD）
③ 切到 board2 → F7 → 下载
④ 两块都要 0 Error 0 Warning
```

也可以不编译，直接烧现成的 hex：

```
板1 → firmware\MDK-ARM\board1\board1.hex
板2 → firmware\MDK-ARM\board2\board2.hex
```

> ★ **烧之前先自检**：`python tools\check_sync.py --hex`
> 打印 ✔ 才说明固件里的网络权重不比模型旧。✘ 就先跑 `python tools\gen_ai_code.py`。
>
> ★ 工程里配的下载器是 **CMSIS-DAP**（`CMSIS_AGDI.dll`）；如果你用的是 ST-Link，
> 在 `Options for Target → Debug` 里换成 ST-Link Debugger 再下载。
>
> ★ 开机横幅会显示 `boardN`，可以核对有没有烧反。
>
> ★ 上电顺序：**先板 2、再板 1**（板 1 要收板 2 的心跳）。

### 1.3 PC 侧（一次性配置 + 每次启动）

```bat
:: ① 建库建表（幂等，只需一次）
python tools\init_db.py

:: ② 确认 pc\db_local.py 里的 MySQL 口令对（本机是 root/123456）
::    没有这个文件就 copy pc\db_local.example.py pc\db_local.py 再改

:: ③ 开移动热点（2.4 GHz！ESP-01S 不支持 5 GHz）
::    ★ 本机热点名必须和固件一致，见 1.7 的说明

:: ④ 启动上位机（想清空旧数据就加 STM32_DB_CLEAR=1）
set STM32_DB_CLEAR=1 && python pc\upper_computer.py
```

启动后：

| 地址 | 内容 |
|---|---|
| `http://127.0.0.1:8000/` | 页① 记录列表（分页、板号颜色、采集时间、AI 判定列） |
| `http://127.0.0.1:8000/chart` | 页② 图形（折线/柱状/面积/饼图/散点 5 种风格） |
| TCP `8080` | 收两块板上报（板1/板2 各一条连接） |

> ★ 防火墙要放行 **8080**（收数据）和 **8000**（网页）。

#### 1.3.1 用 PyCharm 跑（可选）

本机装的是 PyCharm 2026.1.1（`C:\Program Files\JetBrains\PyCharm 2026.1.1`）。

1. **File → Open** → 选**内层** `Lab7\Lab7`（有 `tools\`、`pc\` 的那一层，不是外层壳）；
2. **Settings → Project → Python Interpreter → Add Interpreter → Add Local Interpreter**
   → 选 **Existing** → 指到
   `C:\Users\xiaosu\.workbuddy\binaries\python\envs\default\Scripts\python.exe`
   （tensorflow / sklearn / onnx / pymysql 都装在这个 venv 里）；
3. **Run → Edit Configurations → + → Python**，建三个配置（Working directory 都填工程根）：

| 名字 | Script | Parameters |
|---|---|---|
| 上位机 | `pc\upper_computer.py` | 空（想清库见下） |
| 假板 | `tools\pc_sim_boards.py` | `--ai` |
| 重训 | `tools\retrain.py` | `--skip-export --build`（或 `--check`） |

4. **环境变量**：上位机想每次清空旧数据，在 Run 配置的 Environment variables 里加
   `STM32_DB_CLEAR=1`；不想清就别加（默认保留）；
5. **数据库面板**：View → Tool Windows → Database → `+` → Data Source → MySQL，
   填 `127.0.0.1:3306` / `root` / `123456` / `stm32_lab`，首次会让你下 MySQL 驱动；
6. ★ **8000 / 8080 只能被一个进程占用**：重跑前先点 Stop 停掉旧实例，
   否则报 `Address already in use`（PyCharm 里停不干净就任务管理器结束 python.exe）。

> PyCharm 的 Terminal 默认是 PowerShell，想跑一键脚本用 `.\一键重训.bat`
> 或 `cmd /c 一键重训.bat`。

### 1.4 板上操作

| 操作 | 效果 |
|---|---|
| **KEY0**（PF9） | 开始采集（按**任意一块**都让两块同时开始） |
| **KEY1**（PF8） | 停止采集（两块同时停，LED 灭） |
| **KEY2**（PF7） | 切「数据页 / 状态页」 |
| **KEY3**（PF6） | 板1：重发一次 CAN 快照；板2：恢复 I2C |

上电后**两块板都不采集**（对称设计）；按任意一块的 KEY0 才开始。

### 1.5 串口（USART1，115200-8-N-1）

| 命令 | 作用 |
|---|---|
| `n` | **题2 核心**：对 `ai_test10.h` 里 10 条留出样本逐条判定，打印 判定/置信度/真值/对错 |
| `s` | 状态：运行/序号/温湿/CO₂/TVOC/WiFi/CAN 计数 + AI 判定 |
| `w` | WiFi 状态机 + 5 类重连原因（排错用） |
| `c` | CAN 自测：发一帧心跳 |
| `a 35` | 报警阈值（**只有板1 有效**，默认 35 ℃） |
| `l` / `t` / `g` | 单独读光敏 / SHT30 / SGP30 |

**现场 3 分钟演示顺序**：网页先开好 → 按任意一块 KEY0（两板同时出数 + 呼吸灯）→
按**另一块** KEY1 停、KEY0 再开（验证两板等价）→ 网页两页 → 数据库
`SELECT board,COUNT(*) FROM lab7_data GROUP BY board` → 串口 `n` 的 10 条判定 →
板1 屏上的 `OWN`/`PEER`。

### 1.6 题2 的三处证据（老师最想看这个）

1. **串口敲 `n`** → 10 条逐条判定（板号 + 置信度 + 是否正确）；
2. **网页「AI 判定」列** → 与串口同源；
3. **板 1 屏上的 `OWN` / `PEER`** → 板2 的原始数据经 CAN 传来，板1 用同一模型判，
   证明模型判的是「数据来源」，不是「哪块板在推理」。

### 1.7 ★ 这台电脑与固件的 3 个差异（不处理会连不上/跑不通）

| # | 差异 | 处理 |
|---|---|---|
| 1 | 固件中的 WiFi 名称和密码是待填写占位符 | 在 Windows 移动热点中填写自己的热点参数，并同步修改 `firmware/USER/App/app_id.h` 的 `STU_WIFI_SSID/PASS`，然后重编译两个 Target |
| 2 | 本机 **X-CUBE-AI 缺 `Utilities\windows\stedgeai.exe`** | 转 C 这步过不去；CubeMX → Manage embedded software packages → X-CUBE-AI 10.2.1 重新安装（要 ST 账号）。只演示已有模型则不受影响 |
| 3 | MySQL 里还没有 `lab7_data` 表 | 先 `python tools\init_db.py`；不重新采集就训练时加 `--skip-export` 用现有 CSV |

> 另外：`docs/实验报告.md` 和 `docs/验收演示脚本.md` 还是**旧的 5 通道口径**
> （207 条 / 402 参数 / 温度+光敏主导）。当前固件是**2 通道 354 参数**（温度+湿度）。
> 答辩前要么改文档，要么按第 2 节 D 组的说法解释清楚，别让老师对不上。

---

## 2. 老师可能问的问题

### A. 方案与需求（6 题）

**A1. 题目说「CAN 或 485」，为什么选 CAN？**
CAN 是差分总线，自带 CRC、ACK、仲裁和错误帧，两节点 500 kbps 下几乎不用自己写可靠性逻辑；
板载就有 TJA1050 收发器，实验六也跑通过。485 只是电气层，帧格式、冲突、重传都要自己造。

**A2. 两块板为什么要「等价」？**
题目说「板1 按键1 开始」，但没要求只能板1 控制。做成等价后，任意一块的 KEY0/KEY1 都通过
CAN 控制帧（板1 发 `0x200`、板2 发 `0x201`）通知对板，演示时不用特意找板1。
实现上只有一个入口 `App_SetRunning(run, send_ctrl)`，收到对板控制帧时 `send_ctrl=0`，**绝不转发**，避免两块板互相刷帧。

**A3. 为什么上电两块板都不采集？**
实验六是「从机上电即采」，那样「两块同时开始」就无从谈起。实验七改成上电都不采、按键才采，
这是需求确认时明确的一条（A5）。

**A4. 两块板代码是一样的吗？**
一份 `app_node.c`，靠 `BOARD_SEL` / `IS_MASTER` 在编译期分叉；Keil 里两个 Target
（board1/board2）共用同一套源码，只是宏不同。

**A5. 题目写 OLED，你为什么用 LCD？**
用的是 2.8″ ILI9341（240×320），需求确认时定的：实验六已有成熟 FSMC 驱动和中文点阵，
换 OLED 要重做字库和布局，收益只是「名字对得上」。功能上完全覆盖题目要求。

**A6. 为什么采样是 1 秒一次？**
ESP-01S 实测 CIPSEND 上限约 1.5 次/秒，两块板各 1 帧/秒总负载更低；传感器（SHT30/SGP30）
也不需要更快的刷新。网页和曲线都是按 1 Hz 设计的。

### B. 硬件与 CAN（7 题）

**B1. CAN 帧怎么定义的？**
标准帧、500 kbps、DLC≤8：
`0x100`（板1→板2：seq/temp/humi/light）、`0x101`（eco2/tvoc/status/board）、
`0x110/0x111`（板2→板1，同结构，用于交叉验证）、`0x200/0x201`（控制帧）、`0x180`（心跳，1 Hz）。

**B2. 5 个传感器值超过 8 字节怎么办？**
拆两帧。`0x100` 放序号+温湿光，`0x101` 放 CO₂/TVOC/状态/板号；温度湿度按 ×10 存成有符号整数。

**B3. 为什么用轮询不用 CAN 中断？**
数据率只有 1 Hz，`CanTask` 10 ms 轮询 FIFO0 足够；减少中断嵌套和优先级问题。
CAN 初始化也故意不调 `HAL_CAN_Start()`——它内部等 INAK 依赖 `HAL_GetTick()`，
而本工程 HAL 时基在 TIM6，会死循环（实验六板2 白屏的根因），现在直接清 INRQ 进 Normal。

**B4. 板2 怎么知道板1 掉线？**
3 秒收不到任何 `0x1xx` 判离线，「板1 区」显示 `--`；板1 侧靠 `0x180` 心跳判断板2。

**B5. 呼吸灯怎么做的？**
TIM7 软 PWM，20 ms 步进改变占空比，三色 LED 同步呼吸。两板共用 `led_effect.c`，
只有 `running=1` 才亮；上电不亮。

**B6. 为什么不用外接 120 Ω？**
每块板自带 R35（120 Ω），两块板并联约 60 Ω，短双绞线正合适；再外接会变成 40 Ω，反而加重负载。

**B7. 如果真的没有波形，先查什么？**
P21 跳线（PA11/PA12 与 USB 座二选一）→ 两板共地 → 波特率都是 500 kbps → 串口敲 `c` 发心跳。

### C. WiFi / 协议 / 上位机（7 题）

**C1. 两块板都是 client，谁连谁？**
两块板都是 STA，连 PC 的移动热点（2.4 GHz），各自 TCP 连 `PC:8080`；
板间数据走 CAN，WiFi 只负责上报，两条链路互不耦合。

**C2. 协议长什么样？**
文本帧、逗号分隔：
`H,<姓名>,<学号>,<board>`（握手，板号在最后）、
`D,<board>,<up_ms>,<seq>,<t>,<h>,<light>,<eco2>,<tvoc>,<OK|ALM>,<ai_cls>,<ai_conf>`（1 Hz）、
`S,<board>,START|STOP`（采集状态变化时发）。

**C3. 网页怎么知道采集开始/停止？**
板端 `running` 变化时发 `S` 帧，**发送成功才更新状态**；链路重连后补发一次当前状态，
所以网页打开就能看到正确状态。10 秒收不到任何帧显示「离线」。

**C4. 两块板的采集时间怎么对齐？**
每帧带本板上电毫秒 `up_ms`；PC 为每块板单独标定 offset，换算成 `sample_time`，
同时另存 `recv_time`，可以看链路延迟。

**C5. WiFi 断了怎么办？**
三条通路：① 模块吐 `0,CLOSED` → 标记并重发 `AT+CIPSTART`；② `CIPSEND` 失败兜底（半开连接）；
③ 周期补连（开机时 PC 没开热点也能自己连上）。重连成功必须复位 `+IPD` 解析状态机，否则吃帧。

**C6. 网页为什么是两页？**
题目明确要求「分 2 页」：页①列表（分页/筛选/编辑/导出 CSV/AI 判定列），页②图形（5 种风格）。

**C7. 上位机用了什么框架？**
单文件 Python，标准库 `socket` + `http.server`，零第三方依赖（除可选的 pymysql）；
HTML/JS 内嵌，Canvas 画 5 种图。换机器只要 Python 就能跑。

### D. 神经网络（10 题，重点）

**D1. 模型结构是什么？**
MLP：输入 2 维（温度、湿度）→ 16 → 16 → 2（softmax）。
参数量 354（1.38 KB float32），MACC 416，activations 128 B。

**D2. 为什么输入只有 2 维？题目不是 5 个传感器吗？**
采集、显示、上报仍然是 5 项，**只是网络的输入选了最稳的 2 个**。原因是实测：
- 光敏：同一块板自己就能从 1200 漂到 1519（+27%，开灯/挡光），跨板差异里混着环境光；
- CO₂：跨板只有 0.20σ，TVOC 0.86σ，几乎没有区分度；
- 温湿度是**器件个体差异**，当前这批数据里湿度 10.62σ、温度 5.60σ，单通道 AUC 都是 1.000。
所以 `--features` 默认 `temp,humi`；要 5 通道重训也可以：`--features temp,humi,light,eco2,tvoc`。

**D3. 那题目问「是哪个传感器采集的数据」，怎么回答？**
一条记录本来就是 5 个传感器**同一时刻一起采**的，不存在「这条是温度采的、那条是光敏采的」
这种互斥标签。所以拆成两问：① 判**哪块板**（2 分类）；② 输出**主导通道**
（单通道可分性 + AUC）。这是需求确认时定下的口径，报告里有完整表格。

**D4. 准确率 100% 是不是过拟合？**
有三层证据：
① 每板最后 5 条（共 10 条）**完全不参与训练**，留出测试 10/10；
② 换一个采集批次 210 条做跨批次测试，100%；
③ 烧进板子实测 201 条，判对 200 条（99.5%，唯一错的是开机第一条 SGP30 还在预热）。
（②③ 是上一版 5 通道模型的实测；现在这版 2 通道**答辩前要按同样口径重测一遍**，别拿旧数字硬说。）
而且数据本身单通道就有 5~10σ（AUC 1.000），连逻辑回归都 100%——是数据可分，不是模型背答案。

**D5. 归一化为什么要在板子上再做一遍？**
训练时用 z-score（mean/std 由训练集算），板上没有 sklearn，所以 `train_nn.py` 把
mean/std 导出成 `ai_norm.h`，`Ai_Infer()` 里做同一套变换再喂 `ai_run()`。
这是「PC 训练 + 板上推理」最容易错的一环，参数不一致会得到完全离谱的判定。

**D6. 模型怎么进的 Keil 工程？**
Keras 训练 → 导出 `model.onnx` → `stedgeai generate` 生成 7 个 `network*.c/h` →
放进 `firmware/USER/AI/` → `make_project.py` 挂进两个 Target → 编译 0E0W。
`ai_model.c` 是一层薄封装：归一化 + 调 `ai_run()` + 取 softmax 两类的较大者。

**D7. 为什么用 ONNX 不用 .h5？**
Keras 3 的 `.h5`，stedgeai 10.2.1 认不了；`.onnx` 实测和 Keras 数值等价，是唯一稳定可用的格式。

**D8. 为什么不做 int8 量化？**
模型只有 354 个参数、1.38 KB，F407 有单精度 FPU，float32 完全没压力；
量化收益（省几百字节）远小于输入量化误差带来的风险。

**D9. 10 条演示样本怎么选的？**
每块板 CSV 里**最后 5 条**（时间上最新），不参与训练，固化进 `ai_test10.h`；
串口 `n` 逐条推理。这样演示的是「后续采集、模型没见过」的数据。

**D10. CAN 交叉验证是什么？**
板2 把自己的原始 5 项经 `0x110/0x111` 回传板1；板1 用**自己板上同一份模型**判，
屏上 `OWN b1 99%` / `PEER b2 98%`。证明模型判的是数据来源，不是「谁在推理」。

### E. 数据与实验方法（5 题）

**E1. 为什么强调「采集摆放 = 演示摆放」？**
早期 852 条是两板摆得较开时采的，模型会依赖光敏/CO₂ 的环境差；演示时两板只隔 10 cm，
这个差会消失（CO₂ 两板差从 459 ppm 降到 99 ppm），模型当场翻车。
所以最终数据必须按演示摆法重采。

**E2. 训练前为什么要做可分性检验？**
如果两板数据根本分不开，训出来就是随机模型。`check_separability.py` 用 5 折交叉验证 +
逐通道 AUC + PCA，准确率 <80% 就不让往下走，先调摆放再重采。

**E3. 数据量够吗？**
题面要求每板 ≥100 条。当前 `lab7.csv` 是 147 条（板1 59 / 板2 88），**板1 还差 41 条**，
答辩前要补采；旧的 207 条（106/101）是 5 通道那版的数据。

**E4. ALM 行为什么要剔除？**
ALM 是板1 超温报警（默认 35 ℃）。如果阈值设 28 ℃，室温就会触发，导出时默认 `status='OK'`
会把大片数据剔掉（真踩过：采 161 条剩 42 条）。所以阈值默认改 35 ℃，且只有板1 判 ALM。

**E5. SGP30 第一条为什么是 400 / 0？**
上电预热期读数固定为 400 ppm / 0~2 ppb，属于无效数据。导出时只留 OK 行、演示前先跑 15 秒，
就是为了避开它。

### F. 工程与踩坑（5 题）

**F1. 为什么不用 CubeMX 的 GENERATE CODE？**
① 中文路径下 stedgeai 直接崩（`'gbk' codec can't encode`）；
② 它会改工程：第一个 Target 改名、给文件加「文件级 IncludePath」（AC5 报 C4065E）、
删 `system_stm32f4xx.c`、把 startup 的 `Stack_Size` 改回 0x800。
所以用命令行 `gen_ai_code.py`，只覆盖 7 个网络文件，不碰工程结构。

**F2. 怎么保证板上跑的是最新模型？**
训练不可复现（同 seed 两次权重都不同），所以每次必须
**训练 → 转 C → 编译 → 烧写**一条链走完。`check_sync.py --hex` 比对
`model.onnx` 与 `network_data_params.c` 的时间戳，并打印两个 hex 的 MD5。

**F3. 为什么有两个 Target？**
两板硬件相同、功能等价，只差 `BOARD_SEL`（板1 广播、板2 回传）。一个工程两个 Target
比两套代码好维护，也不会出现「改了板1 忘了板2」。

**F4. 编译资源占用多少？**
board1：Code 45,740 B + RO 16,904 B + RW 2,372 B ≈ **63.5 KB Flash**；
RW + ZI = 32,840 B ≈ **32 KB RAM**。F407ZGT6 是 1 MB Flash / 192 KB RAM，余量很大。

**F5. 如果工程被 CubeMX 重新生成坏了怎么办？**
跑 `python tools\make_project.py firmware` 恢复 USER 文件组和两个 Target；
再确认 startup 的 `Stack_Size` 还是 0x1000。

### G. 追问 / 挖坑（6 题）

**G1. 如果我把两块板交换位置，还能判对吗？**
不能保证。模型学的是**这两块板**的温湿度个体差异，交换后标签就反了。
这正好说明它学的是「器件身份」，不是「位置」。

**G2. 如果换两套新的传感器模块？**
需要重新采集、重训。器件个体差异换了，旧模型不再适用——这是这类「判来源」任务的固有前提。

**G3. 加第三块板要改什么？**
输出层改 3 类（softmax），CAN 增加板3 的 ID，PC 端协议不用大改（board 字段已经是通用的）。
当前工程按题目收敛成两板。

**G4. 为什么不在 PC 上推理，非要在板子上跑？**
题目要求「在串口判定」+ X-CUBE-AI 路线；板上推理断网也能用、延迟低、不依赖 PC。
PC 只负责收数据和展示。

**G5. 模型能不能判断「这是温度还是湿度传感器采的」？**
不能，也不应该——5 个传感器是同时采样的，一条记录同时属于 5 个通道。
能回答的是「哪个通道对判板贡献最大」，见 D3。

**G6. 如果现场重训，你要多久？**
训练本身约 20~30 秒（150 epoch），转 C + 编译约 3~4 分钟，总共 5 分钟内。
用 `一键重训.bat` 一条命令；但本机缺 stedgeai，现场转 C 前要先补装 X-CUBE-AI Utilities。

---

## 3. 现场翻车怎么应对

| 现象 | 一句话解释 + 动作 |
|---|---|
| CAN 一条波形都没有 | 「P21 跳线是 USB/CAN 二选一」→ 插上 3–5、4–6 再试 |
| 板2「板1 区」不刷新 | 先看板1 是否在采（KEY0），再查双绞线 A/B、共地 |
| 网页连上但没数据 | 串口 `w` 看 WiFi 状态机；检查热点名/密码、2.4 GHz、防火墙 8080 |
| 网页打不开 | 8000 端口被旧进程占了：`Get-NetTCPConnection -LocalPort 8000` 找 PID 杀掉 |
| 板上判定明显不对 | 先 `check_sync.py --hex`；大概率是烧了旧 hex 或没转 C |
| CO₂/TVOC 显示 `---` | SGP30 暖机中，等 15 秒；还不行就 `g` 查 I2C |
| 被问「数据不是只有 147 条吗」 | 承认当前 59/88，说明正在补采；旧的 207 条和上板 201 条可作已完成证据 |
| 被问「文档怎么写的 5 通道」 | 说明今早把特征收敛到温湿度（光敏漂移），文档正在同步；指标以 `ai/report/train_report.md` 为准 |

---

## 4. 关键数字速记

| 项 | 值 |
|---|---|
| 采样周期 / CAN 速率 | 1 Hz / 500 kbps |
| CAN ID | `0x100/0x101`（板1 数据）、`0x110/0x111`（板2 回传）、`0x200/0x201`（控制）、`0x180`（心跳） |
| 模型 | MLP 2→16→16→2，**354 参数**，1.38 KB 权重，128 B activations，MACC 416 |
| 归一化 | 温度 24.1358 ± 0.1947，湿度 65.7964 ± 3.3332 |
| 数据集 | 147 条（板1 59 / 板2 88）；训练 109 / 验证 28 / 留出 10 |
| 准确率 | 训练/验证 **1.0000**；留出 10/10；旧 5 通道版上板 201 条 **99.5%**、跨批次 210 条 100% |
| 固件 | ≈63.5 KB Flash / ≈32 KB RAM；两个 Target 0E0W |
| 工具链 | Keil ARMCC V5.06、X-CUBE-AI 10.2.1、TensorFlow 2.21、Python 3.13 |
| 网页 / 数据库 | `:8000` 两页；`stm32_lab.lab7_data` 14 列 |

---

## 5. 答辩前检查清单

- [ ] 两个 hex 都是**刚编译的**，`check_sync.py --hex` 打印 ✔
- [ ] 热点名/密码与固件一致（填写自己的热点参数），2.4 GHz
- [ ] MySQL 已建表，`STM32_DB_CLEAR=1` 清过旧数据（或明确保留）
- [ ] P21 跳线、CAN 双绞线、共地、不外接 120 Ω
- [ ] 两板摆放与采集时一致，SGP30 上电等 15 秒
- [ ] 串口敲 `n` 能打出 10 条判定；屏上 OWN/PEER 正常
- [ ] 网页两页能开、状态条随 KEY0/KEY1 变化
- [ ] 文档口径与固件一致（2 通道/354 参数），或准备好口头解释
- [ ] 数据补到每板 ≥100（当前板1 59，差 41 条）
- [ ] 录像 ≤5 分钟，按 `docs/录像脚本.md` 走一遍

> **姓名：郑鑫　　学号：202440700111**
