741-xiao/stm32f407-dual-board-ai/docs/验收演示脚本.md

# 实验七 · 验收演示操作单（两块板）

> **姓名：郑鑫　学号：202440700111**
>
> 对照 `需求确认.md` 的 **A / B / C / D**（题1）+ **G1~G8**（题2）+ **H1/H2**（题3）逐条演示。
> 烧好 `board1` / `board2` 两个 hex 后从上往下做；每步都标了**该存哪张截图**（题3 文档用，见 §5）。

---

## 0. 准备清单

| 类别 | 物品 | 数量 | 备注 |
|---|---|---|---|
| 主控 | STM32F407 开发板 | **2** | 板1（广播者）/ 板2 |
| 显示 | 2.8″ TFT LCD（ILI9341） | 2 | FSMC NE4，240×320 |
| 传感器 | SHT30 温湿度 | 2 | I2C1，**从 P18 摄像头座引**（PB6/PB7） |
| 传感器 | **SGP30**（eCO₂ / TVOC） | 2 | **I2C2（PF0/PF1）** |
| 传感器 | 光敏 AO 模块 | 2 | **ADC1_IN10（PC0）**，从 P19 音乐模块座引 |
| 通信 | ESP-01S | 2 | UART4（PA0/PA1），CH_PD=PF14 |
| 通信 | CAN 收发器 | 0 | ★ **板载**（U9 TJA1050），不用外接 |
| 总线 | 双绞线（CANH/CANL） | 1 | ★ **不必外接 120Ω**（板载 R35） |
| 跳线 | 短路帽 | **4** | ★ 每板 2 个，短接 P21 的 3–5 / 4–6 |
| 上位机 | PC + Python | 1 | 开移动热点 |

---

## 1. ★ 上电前的三个硬检查（最容易翻车）

| # | 检查 | 症状对照 |
|---|---|---|
| 1 | **P21 短接 3–5 和 4–6**（PA11/PA12 与 USB 座二选一） | 不跳 = 程序全对，但**CAN 总线上一点波形都没有** |
| 2 | **CANH↔CANH、CANL↔CANL，两板必须共地** | 不共地 → 差分无共模参考，时通时断 |
| 3 | ★★ **两板的摆放 = 演示时的摆放**（贴在一起、CAN 线连好就别再挪） | 摆放一变，数据分布就变，模型可能当场翻车 |

> 传感器：SHT30 / SGP30 两条 I2C **都无板载上拉** ⇒ 模块必须自带；**光敏、SGP30 不要互相挨着**（SGP30 会受邻近影响）。

---

## 2. 烧录与上电

```bat
:: ① 烧写前先自检：固件里的网络权重是不是比模型旧？
python tools\check_sync.py --hex
::   → 应打印 ✔ + 两个 hex 的 md5/时间；✘ 就先去跑 gen_ai_code.py

:: ② 先启动上位机（★ 要清空旧数据再加 STM32_DB_CLEAR=1）
set STM32_DB_CLEAR=1 && python pc\upper_computer.py
::   网页①(列表) http://127.0.0.1:8000/    网页②(图形) http://127.0.0.1:8000/chart
```

3. **烧写**：板1 → `firmware\MDK-ARM\board1\board1.hex`，板2 → `board2\board2.hex`
   （开机横幅有 `boardN`，可核对有没有烧反）
4. **两板上电 → 两块都不采**（A5 的要求；实验六是"从机上电即采"，这里已改成对称）
5. **阈值默认已是 35℃，不用敲**（原 28℃ 会被室温直接触发）——
   ★★ 而且**只有板1 判 ALM**（判定包在采样任务的 `#if IS_MASTER` 里），
   板2 敲 `a` 不会改变任何东西。以前"两块板各敲一次"有一半是白做的。
   要演示「超温报警」：敲 `a 28` 立刻触发（室温就超），演示完 `a 35` 恢复。

---

## 3. 题1 验收（A / B / C / D）

### A 组 · 采集开关（**两板等价**）

| # | 操作 | 预期（判据） | 截图 |
|---|---|---|---|
| A1 | 按**任意一块板**的 KEY0 | 该板串口 `[KEY] ... 开始`；**两块板同时开始**采本板 5 项 | S1 |
| A2 | 看两板屏 | 各自「本板」区 5 项（温/湿/光敏/CO₂/TVOC）1Hz 刷新，序号递增 | S1 |
| A3 | 看板1 串口 | 每秒一行 `[数据] ...`（5 项齐全） | — |
| A4 | **换成板2 的 KEY0 再试一次**（反向验证） | 同样带动**两块**一起开始 | S2 |
| A5 | 上电后**不按键** | ★ 两块板都**不采**（序号不动、LED 不亮） | — |
| A6 | 按任意一块板的 KEY1 | 两块板**同时停**；两板 LED 灭；板2「板1 区」回 `--` | S2 |

### B 组 · 呼吸灯（两板都有）

| # | 操作 | 预期 | 截图 |
|---|---|---|---|
| B1 | 采集期间看两板 LED | **都呈呼吸灯**（渐亮渐暗循环） | S3 |
| B2 | 按 KEY1 停止 | 两板 LED **全灭** | — |
| B3 | 上电未采集时 | 两板 LED **都不亮**（不是"上电即呼吸"） | — |

### C 组 · CAN 互显 + WiFi 上报 + 入库

| # | 操作 | 预期 | 截图 |
|---|---|---|---|
| C1 | 采集期间看**板2 屏**「板1 区」 | 5 项**跟着刷新**（板1 经 CAN `0x100/0x101` 广播过来）；标题**变绿** | S4 |
| C2 | 板2 断电约 3s | 板1 屏对板状态变**错误**（心跳 `0x180` 超时） | — |
| C3 | 两板串口 | 各出现 `[WiFi] handshake ... (H,郑鑫,202440700111,bN)` | S5 |
| C4 | PC 控制台 | 两板数据行都在刷 | S5 |
| C5 | MySQL | `lab7_data` 有数据，`board` 与 `sample_time` 能区分两板与时间；另有 `recv_time`、`ai_cls`、`ai_conf` | S6 |

### D 组 · 网页两页

| # | 操作 | 预期 | 截图 |
|---|---|---|---|
| D1 | 打开 `http://127.0.0.1:8000/` | 页①**记录列表**；顶部导航可跳页② | S7 |
| D2 | 翻页 | 首/上/下/末页可切；新数据实时进列表 | S7 |
| D3 | 看列表 | 每行有**板号徽标**（板1 蓝 / 板2 橙，两色区分）+ **采集时间** | S7 |
| D4 | 打开 `/chart` | 页②**5 张图 5 种风格**：温度折线 / 湿度柱状 / 光敏面积 / CO₂ 饼图 / TVOC 散点 | S8 |
| D5 | 按板1 KEY0 / KEY1 | 网页**状态条**在「采集进行中 ↔ 已停止」间实时切换（由板端 S 帧驱动） | S9 |
| D6 | —— | 语言：Python（单文件零依赖） | — |

> 状态条颜色/文案由 `S,<board>,START|STOP` 帧驱动；板端**发成功才更新状态**。

---

## 4. 题2 验收（G1~G8）

| # | 条款 | 怎么验 | 结果 / 截图 |
|---|---|---|---|
| G1 | 两板各 ≥100 条 | `python tools\export_dataset.py --min-per-board 100` | 已采 **板1 106 / 板2 101 = 207 条** ✔ |
| G2 | 训练 + 准确率 + 混淆矩阵 | 看 `ai\report\train_report.md` | 训练/验证 **1.0000**；混淆矩阵见 S10 |
| G3 | X-CUBE-AI 转 C 并集成 | `firmware\USER\AI\` + `ai\report\stedgeai_*.txt`；两 Target **0E0W** | S11 |
| G4 | 板端推理 | 屏上 `OWN bN xx%`、D 帧带 `ai_cls/ai_conf` | S12、S13 |
| G5 | **串口 10 条判定** | 串口敲 **`n`** → 逐条打印 `truth=b1 -> b1 100% OK` | **S12**（★ 文档必备） |
| G6 | 网页同步显示判定 | 页① 的 **「AI 判定」列**（判对绿、判错红） | **S13** |
| G7 | 「哪个传感器」 | `ai\report\train_report.md` §4：**① 单通道可分性**（温度 49.3σ/AUC 1.000 · 光敏 46.1σ · 湿度 7.6σ…）+ ② 模型梯度显著性 | S10 |
| G8 | **CAN 交叉喂数据闭环** | 板2 把本板原始 5 项经 `0x110/0x111` 回传板1 → 板1 判"这条来自哪块板" → 屏上 `PEER bN` | **S12** |

> ★ G5/G8 是同一张串口截图里最硬的两块：`n` 命令逐条判定 + 屏上 `OWN/PEER` 双向。
> 讲 G7 时**以"单通道可分性"为准**：`|∂p/∂x|` 在模型输出饱和（置信度≈100%）时会失真，
> 报告里已注明它只说明"模型把权重放在哪"。

---

## 5. 截图清单（题3 文档直接用，编号对应上文）

| 编号 | 拍什么 | 来源 |
|---|---|---|
| S1 | 按 KEY0 后**两块板屏**同时出数（A1/A2） | 手机/相机 |
| S2 | 按 **板2** 的 KEY0/KEY1 也能带动两板（A4/A6） | 手机 |
| S3 | 两板 LED 呼吸灯（B1） | 手机 |
| S4 | 板2 屏「板1 区」在刷新（C1） | 手机特写 |
| S5 | 两板串口 `[WiFi] handshake` + PC 控制台收数据（C3/C4） | 串口助手截图 |
| S6 | MySQL `lab7_data` 查询结果（C5） | 客户端截图 |
| S7 | 网页① 列表页（含**分页**、板号色、AI 判定列）（D1~D3） | 浏览器截图 |
| S8 | 网页② 图形页 5 种风格（D4） | 浏览器截图 |
| S9 | 网页状态条「采集进行中 / 已停止」两态（D5） | 浏览器截图 ×2 |
| S10 | `train_report.md` 的准确率 + 混淆矩阵 + 通道重要性（G2/G7） | 报告截图 |
| S11 | `firmware\USER\AI\` 目录 + 编译 0E0W（G3） | Keil/资源管理器 |
| S12 | **串口 `n` 的 10 条判定** + 屏上 `OWN/PEER`（G5/G8） | 串口助手 + 手机 |
| S13 | 网页「AI 判定」列（G6） | 浏览器截图 |
| S14 | 环境：X-CUBE-AI 已装（题0） | CubeMX 界面 |

> **文档 ≥3 页**：建议 ① 系统框图 + 硬件接线（含 P21 跳线） ② 题1 演示（S1~S9）
> ③ 题2 流程（可分性 → 训练 → 转 C → 板上推理，S10~S13）+ 通道重要性结论。
> **每页都要有姓名与学号**（H1 要求）。

---

## 6. 按键 / 串口命令速查

### 6.1 按键（板上网络名 KEY0..KEY3；中间键 = RESET）

| | KEY0 (PF9) | KEY1 (PF8) | KEY2 (PF7) | KEY3 (PF6) |
|---|---|---|---|---|
| **板1** | **开始采集** + CAN START | **停止采集** + CAN STOP | 切 数据页/状态页 | 手动重发一次 CAN 快照 |
| **板2** | **开始采集** + CAN START | **停止采集** + CAN STOP | 切 数据页/状态页 | 手动恢复 I2C 总线 |

> ★ 两板 KEY0/KEY1 **行为完全相同**（题1 要求"按任意一板都能一起启停"）；
> 屏底提示 `KEY2:page KEY3:act`。
> **状态页**（KEY2 切过去）把 WiFi 状态机 / CAN 收发计数 / 传感器是否正常 / 对板在线 / 序号全画在屏上，
> 演示时不用连串口也能看出哪个环节出问题。

### 6.2 串口命令（USART1 115200-8-N-1，单字符 + 回车）

| 键 | 作用 |
|---|---|
| `?` | 命令帮助 |
| `l` | 读光敏（raw / avg / pct） |
| `t` | 读一次 SHT30 |
| `g` | 读一次 SGP30（eCO₂ / TVOC） |
| `s` | 状态：运行/序号/温湿/eCO₂/TVOC/WiFi/CAN 收发计数 **+ AI 判定** |
| `w` | WiFi 状态机（含 5 类重连原因计数，排错用） |
| `c` | **CAN 自测**：发一帧心跳（查总线通不通） |
| **`a <C>`** | **报警阈值**（**只有板1 有效**，板2 敲了不变）：默认已是 35℃，平时不用敲；演示"超温报警"时 `a 28` 立刻触发，完事 `a 35` 恢复 |
| **`n`** | ★ **题2 演示**：把 `ai_test10.h` 那 10 条留出样本逐条推理，打印 `判定/置信度/真值/对错` |

---

## 7. 故障速查

| 现象 | 原因 / 处理 |
|---|---|
| CAN 上毫无波形 / 板2 收不到数据 | ★★ **P21 没短接 3–5、4–6**（最常见）→ 再查共地 → 两板都 500kbps |
| 板1 屏对板状态一直**错误** | 板2 没上电 / CAN 断 / 波特率不符 |
| 网页连上但**一个字节都没有** | 板端 WiFi 状态机没到 READY（看状态页或串口 `w`） |
| 库里没数据 | `[DB] 未启用` → 没装 pymysql / 没写 `pc\db_local.py` / 表没建 |
| 两板 CO₂/TVOC 显示 `---` | SGP30 **暖机中**（上电约 15s 内正常）；15s 后仍 `---` → I2C 没接好（`g` 查） |
| 网页图看不出两块板 | 确认 `S` 帧到了（状态条在动）；假板/真板都行 |
| **重训后板上判定没变 / 明显错** | ★ 忘了跑 `python tools\gen_ai_code.py` → 板上是"新归一化 + 旧权重"。先 `check_sync.py` 自检 |
| 编译报 `cannot open source input file "ai_model.h"` | `firmware.uvprojx` 被 `git checkout --` 回滚掉了 AI 文件组 → 重跑 `python tools\make_project.py firmware` |
| 改了 PC 代码没生效 | 旧 python 进程没退：`Get-NetTCPConnection -State Listen -LocalPort 8000` 找 PID → `Stop-Process` |
| 板1 一直报警 | 环境温度 > 阈值（默认 35℃）：串口 `a 40` 再调高；或检查是不是手/笔记本出风口一直烤着传感器 |

---

## 8. 演示前的最后检查

- [ ] `python tools\check_sync.py --hex` **✔**（固件里的权重不落后于模型）
- [ ] 两个 hex 都重烧过（时间戳是刚编译的）
- [ ] P21 跳线帽已插（两板）、CAN 双绞线 + 共地、**没外接 120Ω**
- [ ] 阈值确认（默认 35℃，**一般不用动**；若刚演示过超温，记得 `a 35` 恢复）
- [ ] PC 热点已开、上位机已启动（`STM32_DB_CLEAR=1` 清过表）、防火墙放行 8080/8000
- [ ] 两板**摆放 = 采集时的摆放**，中途不再挪动
- [ ] SGP30 上电后**等满 15s** 再讲 CO₂/TVOC（避开暖机）
- [ ] 截图按 §5 的 S1~S14 拍全，**每页文档都写上姓名与学号**
