741-xiao/stm32f407-dual-board-ai/docs/shot/README.md

# docs/shot/ —— 实验报告插图目录

`docs/实验报告.md` 里的 `![Sx](shot/Sx.png)` 就从这个目录取图。
把现场拍/截的图片按下面的文件名存进来，报告就能直接渲染（转 Word 时自动嵌入）。

## 需要放的图

| 文件名 | 内容 | 怎么来 |
|---|---|---|
| `S0.png` | 整机接线实物（两板 + CAN 双绞线 + P21 跳线 + ESP-01S） | 手机拍 |
| `S1.png` | 按 KEY0 后两块板屏同时出数（含板 2 的「板 1 区」） | 手机拍 |
| `S2.png` | 按**板 2** 的 KEY0/KEY1 也能带动两块板 | 手机拍 |
| `S3.png` | 两块板 LED 呼吸灯 | 手机拍 |
| `S5.png` | 两板串口 `[WiFi] handshake` + PC 接收日志 | 串口助手/终端截图 |
| `S6.png` | MySQL `lab7_data` 的查询结果 | 数据库客户端截图 |
| `S7.png` | 网页① 记录列表（分页 + 板号 + 采集时间 + AI 判定列） | 浏览器截图 |
| `S8.png` | 网页② 图形页 5 种风格 | 浏览器截图 |
| `S9.png` | 网页状态条「采集进行中」与「已停止」 | 浏览器截图 ×2（可拼一张） |
| `S10.png` | `ai/report/train_report.md` 的准确率 + 混淆矩阵 + 通道重要性 | 打开报告截图 |
| `S11.png` | `firmware/USER/AI/` 目录 + Keil 编译 0 Error 0 Warning | Keil / 资源管理器截图 |
| `S12.png` | 串口敲 `n` 输出的 10 条判定结果 | 串口助手截图 |
| `S13.png` | 网页「AI 判定」列（能看到 10 条对错） | 浏览器截图 |
| `S14.png` | X-CUBE-AI 10.2.1 已安装（题 0） | CubeMX 截图 |
| `S17.png` | 板 1 屏上的 `OWN` / `PEER` 交叉判定 | 手机特写 |

> **S15 / S16 不用放这里**：报告直接引用了 `ai/report/` 下已生成的
> `sep_hist.png` / `sep_pca.png` / `train_curve.png` / `confusion_matrix.png`。

## 命名要求

- 一律 **`S<编号>.png`**（大写 S，两位内数字），与上表一致，否则报告里是破图。
- 手机拍的照片建议先裁掉无关背景、保证**文字可辨认**（尤其 LCD 和串口窗口）。
- 分辨率不必很大，宽度 1000~1600 px 足够，避免文档体积过大。

## 拍完后

告诉 WorkBuddy「插图齐了」，即可把 `docs/实验报告.md` 渲染成 Word 提交版。
