741-xiao/stm32f407-dual-board-ai/ai/report/far_train_report.md

# 实验七 题2 · 神经网络训练报告

> 由 `tools/train_nn.py` 自动生成；数据源 `ai/dataset/lab7.csv`

## 1. 数据

- 总样本 852 条（板1 426 / 板2 426），剔除 ALM 行
- 训练 672 / 验证 170 / **留出演示 10**（每板最后 5 条，不参与训练）

## 2. 模型

| 层 | 输出形状 | 参数量 |
|---|---|---|
| fc1 | (16,) | 96 |
| fc2 | (16,) | 272 |
| out | (2,) | 34 |

结构：5 → 16 → 16 → 2(softmax)；参数量 **402**（≈1.57 KB float32）

归一化（**板上必须一致**）：

| 通道 | mean | std |
|---|---|---|
| 温度 | 28.2290 | 0.6183 |
| 湿度 | 57.2707 | 1.5704 |
| 光敏 | 2086.6733 | 296.8899 |
| CO2 | 877.8634 | 311.3301 |
| TVOC | 317.2233 | 118.0583 |

## 3. 训练结果

- 训练轮数 300（早停）
- **训练准确率 1.0000**
- **验证准确率 1.0000**（混淆矩阵重算 1.0000）

验证集混淆矩阵（行=真实，列=预测）：

|  | 预测板1 | 预测板2 |
|---|---|---|
| **真实板1** | 85 | 0 |
| **真实板2** | 0 | 85 |

通道重要性（全样本平均 |∂p/∂x| 归一化，越大越关键）：

- 光敏：0.355
- 湿度：0.184
- 温度：0.179
- CO2：0.174
- TVOC：0.108

## 4. 题2 演示：10 条「后续数据」的逐条判定

```
  1  板1    板1    100.0% ✔      光敏、湿度
  2  板1    板1    100.0% ✔      光敏、湿度
  3  板1    板1    100.0% ✔      光敏、湿度
  4  板1    板1    100.0% ✔      光敏、湿度
  5  板1    板1    100.0% ✔      光敏、湿度
  6  板2    板2    100.0% ✔      温度、CO2
  7  板2    板2    100.0% ✔      温度、湿度
  8  板2    板2    100.0% ✔      温度、湿度
  9  板2    板2    100.0% ✔      温度、湿度
  10 板2    板2    100.0% ✔      温度、湿度
```

判对 10/10。这两列也是板端 `ai_test10.h` 里固化的那 10 条。
