741-xiao/stm32f407-dual-board-ai/ai/report/separability.md

# 实验七 题2 · 两板数据可分性检验报告

> 由 `tools/check_separability.py` 自动生成，数据源：`ai/dataset/lab7.csv`

```

【1】逐通道统计（板1 vs 板2）—— 差异越大越好判
  通道     板1 均值±标准差          板2 均值±标准差          相对差        单通道AUC
  温度     23.9 ± 0.1         24.3 ± 0.0         5.64σ      1.000  ← 这个通道最有区分度
  湿度     69.9 ± 0.8         63.1 ± 0.4         10.71σ     1.000  ← 这个通道最有区分度
  光敏     1507.7 ± 102.1     2664.1 ± 19.5      19.02σ     1.000  ← 这个通道最有区分度
  CO2    516.6 ± 25.5       463.0 ± 28.1       2.00σ      0.882  ← 这个通道最有区分度
  TVOC   109.2 ± 33.7       51.0 ± 14.5        2.42σ      0.908  ← 这个通道最有区分度

【2】只用单个通道做 5 折交叉验证（看信号主要落在哪个传感器上）
  温度     准确率 1.000
  湿度     准确率 1.000
  光敏     准确率 1.000
  CO2    准确率 0.912
  TVOC   准确率 0.898

【3】5 个通道合起来，5 折交叉验证
  逻辑回归     准确率 1.000 ± 0.000   （各折 1.00 1.00 1.00 1.00 1.00）
  随机森林     准确率 1.000 ± 0.000   （各折 1.00 1.00 1.00 1.00 1.00）

  逻辑回归 的混淆矩阵（行=真实，列=预测；0=板1 1=板2）
           预测板1  预测板2
    真实板1      59        0
    真实板2       0       88

【4】结论
  ✔ 最好模型 逻辑回归 准确率 1.000 ≥ 0.80 —— **可分**，可以进入训练。
    最强通道：温度、湿度

  图已存：ai\report\sep_pca.png / ai\report\sep_hist.png
```
