741-xiao/stm32f407-dual-board-ai/ai/report/train_report.md

# 实验七 题2 · 神经网络训练报告

> 由 `tools/train_nn.py` 自动生成；数据源 `ai/dataset/lab7.csv`

## 1. 数据

- 总样本 147 条（板1 59 / 板2 88）
- 状态位：全部为 `OK`（采集时未发生超温报警）
- 训练 109 / 验证 28 / **留出演示 10**（每板最后 5 条，不参与训练）

## 2. 模型

| 层 | 输出形状 | 参数量 |
|---|---|---|
| fc1 | (16,) | 48 |
| fc2 | (16,) | 272 |
| out | (2,) | 34 |

结构：5 → 16 → 16 → 2(softmax)；参数量 **354**（≈1.38 KB float32）

归一化（**板上必须一致**）：

| 通道 | mean | std |
|---|---|---|
| 温度 | 24.1358 | 0.1947 |
| 湿度 | 65.7964 | 3.3332 |

## 3. 训练结果

- 训练轮数 300（早停）
- **训练准确率 1.0000**
- **验证准确率 1.0000**（混淆矩阵重算 1.0000）

验证集混淆矩阵（行=真实，列=预测）：

|  | 预测板1 | 预测板2 |
|---|---|---|
| **真实板1** | 11 | 0 |
| **真实板2** | 0 | 17 |

## 4. 通道重要性（题面「哪个传感器」的答案）

**① 单通道可分性**（结论以此为准）—— 只看这一个通道能不能分开两板：

| 通道 | 板1 均值 | 板2 均值 | 相对差 | 单通道 AUC |
|---|---|---|---|---|
| 湿度 | 69.88 | 63.14 | **10.62σ** | 1.000 |
| 温度 | 23.88 | 24.29 | **5.60σ** | 1.000 |

② 模型梯度显著性（全样本平均 |∂p/∂x|，已归一化）—— 模型**实际**在靠哪些通道：

- 湿度：0.675
- 温度：0.325

> ★ ② 的局限：模型输出一旦饱和（置信度≈100%），|∂p/∂x| 会整体变小，
> **排序在不同训练轮次之间并不稳定**，所以它只能说明「模型把权重放在哪」,
> **不能**用来回答「哪个传感器最能区分两块板」—— 那个问题看 ① 的 AUC / 相对差。

## 5. 题2 演示：10 条「后续数据」的逐条判定

```
  1  板1    板1    100.0% ✔      湿度、温度
  2  板1    板1    100.0% ✔      湿度、温度
  3  板1    板1    100.0% ✔      湿度、温度
  4  板1    板1    100.0% ✔      湿度、温度
  5  板1    板1    100.0% ✔      湿度、温度
  6  板2    板2    100.0% ✔      湿度、温度
  7  板2    板2    100.0% ✔      湿度、温度
  8  板2    板2    100.0% ✔      湿度、温度
  9  板2    板2    100.0% ✔      湿度、温度
  10 板2    板2    100.0% ✔      湿度、温度
```

判对 10/10。这两列也是板端 `ai_test10.h` 里固化的那 10 条。
