741-xiao/stm32f407-dual-board-ai/docs/代码规范自查.md

# 代码规范自查（华为 C 语言编程规范 · 可自动化部分）

- 扫描范围：`firmware/USER`（138 个文件 / 27355 行）
- 行长上限：120
- 合计问题：**815 处**

## [1-4] 一行只写一条语句 —— 28 处

| 文件 | 行 | 说明 |
|---|---|---|
| `firmware/USER/App/app_node.c` | 501 | LOCK(); s = g; UNLOCK(); /* 快照，锁外再画（画屏慢，别占着锁）*/ |
| `firmware/USER/App/app_node.c` | 817 | LOCK(); req = g.i2c_recover; g.i2c_recover = 0U; UNLOCK(); |
| `firmware/USER/App/app_node.c` | 821 | LOCK(); run = g.running; UNLOCK(); |
| `firmware/USER/App/app_node.c` | 1003 | LOCK(); ctrl = g.ctrl_pending; g.ctrl_pending = 0U; UNLOCK(); |
| `firmware/USER/App/app_node.c` | 1040 | LOCK(); force = g.resend; g.resend = 0U; UNLOCK(); |
| `firmware/USER/App/app_node.c` | 1042 | LOCK(); s = g; UNLOCK(); |
| `firmware/USER/App/app_node.c` | 1109 | LOCK(); s = g; UNLOCK(); |
| `firmware/USER/App/app_node.c` | 1159 | LOCK(); g.b1_have = 0U; UNLOCK(); /* STOP：清「板1区」，回到占位 */ |
| `firmware/USER/App/app_node.c` | 1234 | LOCK(); g.resend = 1U; UNLOCK(); |
| `firmware/USER/App/app_node.c` | 1237 | LOCK(); g.i2c_recover = 1U; UNLOCK(); |
| `firmware/USER/App/app_node.c` | 1266 | if (g.greeted == 0U) { g.greeted = 1U; need_hello = 1U; } |
| `firmware/USER/App/app_node.c` | 1294 | LOCK(); run = g.running; UNLOCK(); |
| `firmware/USER/App/app_node.c` | 1320 | LOCK(); acls = g.ai_own_cls; aconf = g.ai_own_conf; UNLOCK(); |
| `firmware/USER/App/app_node.c` | 1365 | LOCK(); s = g; UNLOCK(); |
| `firmware/USER/App/app_node.c` | 1380 | LOCK(); g.ai_own_cls = cls; g.ai_own_conf = conf; UNLOCK(); |
| `firmware/USER/App/app_node.c` | 1389 | LOCK(); g.ai_peer_cls = cls; g.ai_peer_conf = conf; UNLOCK(); |
| `firmware/USER/App/app_node.c` | 1406 | LOCK(); s = g; UNLOCK(); |
| `firmware/USER/App/app_node.c` | 1455 | LOCK(); s = g; UNLOCK(); |
| `firmware/USER/App/app_node.c` | 1542 | LOCK(); pg = g.page; UNLOCK(); |
| `firmware/USER/App/app_node.c` | 1573 | LOCK(); on = (u8)((g.running != 0U) ? 1U : 0U); UNLOCK(); |
| `firmware/USER/App/app_node.c` | 1640 | while ((*p >= '0') && (*p <= '9')) { v = (v * 10) + (s32)(*p - '0'); has = 1U; p++; } |
| `firmware/USER/App/app_node.c` | 1643 | LOCK(); g_alarm_thr_x10 = v * 10; UNLOCK(); |
| `firmware/USER/App/app_node.c` | 1693 | LOCK(); s = g; UNLOCK(); |
| `firmware/USER/LED/led_effect.c` | 68 | LED0 = 0; LED1 = 0; LED2 = 0; /* 低电平点亮 */ |
| `firmware/USER/LED/led_effect.c` | 72 | LED0 = 1; LED1 = 1; LED2 = 1; /* 全灭（关效果时也走这里）*/ |
| `firmware/USER/LED/led_effect.c` | 97 | LED0 = 1; LED1 = 1; LED2 = 1; /* 全灭 */ |
| `firmware/USER/WIFI/esp01s_client.c` | 414 | else { px_got = 0U; px_st = PX_PAY; } |
| `firmware/USER/WIFI/esp01s_client.c` | 1098 | else if (ch == (u8)':') { j++; sep = 1U; break; } |

## [1-5] if/for/while 缺大括号 —— 10 处

| 文件 | 行 | 说明 |
|---|---|---|
| `firmware/USER/AI/network.c` | 470 | if (!ai_platform_api_get_network_report(network, &r)) return false; |
| `firmware/USER/AI/network.c` | 518 | if (!ai_platform_api_get_network_report(network, &r)) return false; |
| `firmware/USER/AI/network.c` | 616 | if (!net_ctx) return false; |
| `firmware/USER/AI/network_data.c` | 93 | if (!params) return false; |
| `firmware/USER/AI/runtime/Inc/ai_datatypes_internal.h` | 141 | if ((pos_) < AI_STRIDE_SIZE(stride_)) AI_STRIDE_ELEM(stride_, pos_) = (val_); |
| `firmware/USER/AI/runtime/Inc/core_private.h` | 285 | if (!meta) return NULL; |
| `firmware/USER/KEY/key.c` | 48 | if (KEY0 == 0) key_tem = 1U; |
| `firmware/USER/LCD/lcd.c` | 733 | if(x>=lcd_width) break; |
| `firmware/USER/LCD/lcd.c` | 770 | while(n--)mid*=a; |
| `firmware/USER/LCD/lcd.c` | 827 | if(mode)LCD_DisplayChar(x+(size/2)*t,y,'0',size); |

## [1-6] TAB 缩进 —— 523 处

| 文件 | 行 | 说明 |
|---|---|---|
| `firmware/USER/AI/network.c` | 341 | 含 TAB |
| `firmware/USER/AI/network.c` | 347 | 含 TAB |
| `firmware/USER/AI/network.c` | 356 | 含 TAB |
| `firmware/USER/AI/runtime/Inc/layers_common.h` | 271 | 含 TAB |
| `firmware/USER/AI/runtime/Inc/layers_ml_treeensembleclassifier.h` | 42 | 含 TAB |
| `firmware/USER/LCD/lcd.c` | 21 | 含 TAB |
| `firmware/USER/LCD/lcd.c` | 29 | 含 TAB |
| `firmware/USER/LCD/lcd.c` | 30 | 含 TAB |
| `firmware/USER/LCD/lcd.c` | 31 | 含 TAB |
| `firmware/USER/LCD/lcd.c` | 43 | 含 TAB |
| `firmware/USER/LCD/lcd.c` | 44 | 含 TAB |
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
| `firmware/USER/LCD/cfont.h` | 299 | 252 列 |
| `firmware/USER/LCD/cfont.h` | 300 | 252 列 |
| `firmware/USER/LCD/cfont.h` | 301 | 252 列 |
| `firmware/USER/LCD/cfont.h` | 302 | 252 列 |
| `firmware/USER/WIFI/esp01s_client.c` | 1611 | 126 列 |
| `firmware/USER/WIFI/esp01s_client.c` | 1709 | 126 列 |
