741-xiao/stm32f407-dual-board-ai/ai/report/far_train_curve.png

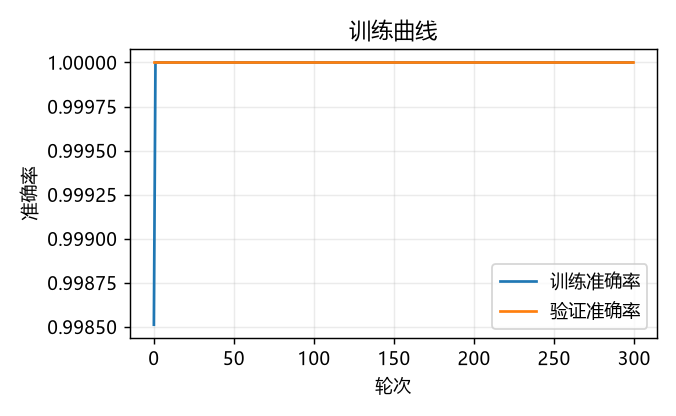
ai/report/far_train_curve.png
