741-xiao/stm32f407-dual-board-ai/docs/sch/can1_out.png

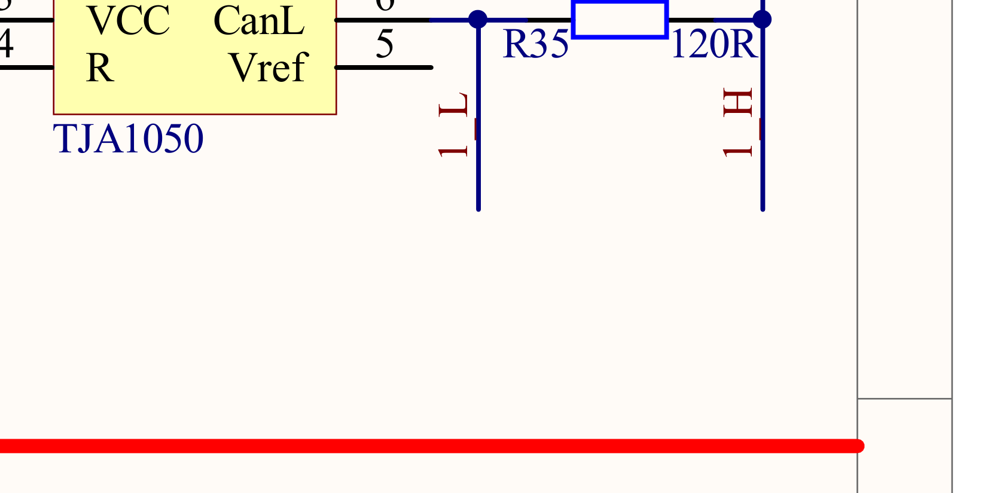
docs/sch/can1_out.png
