741-xiao/stm32f407-dual-board-ai/docs/sch/can1_term.png

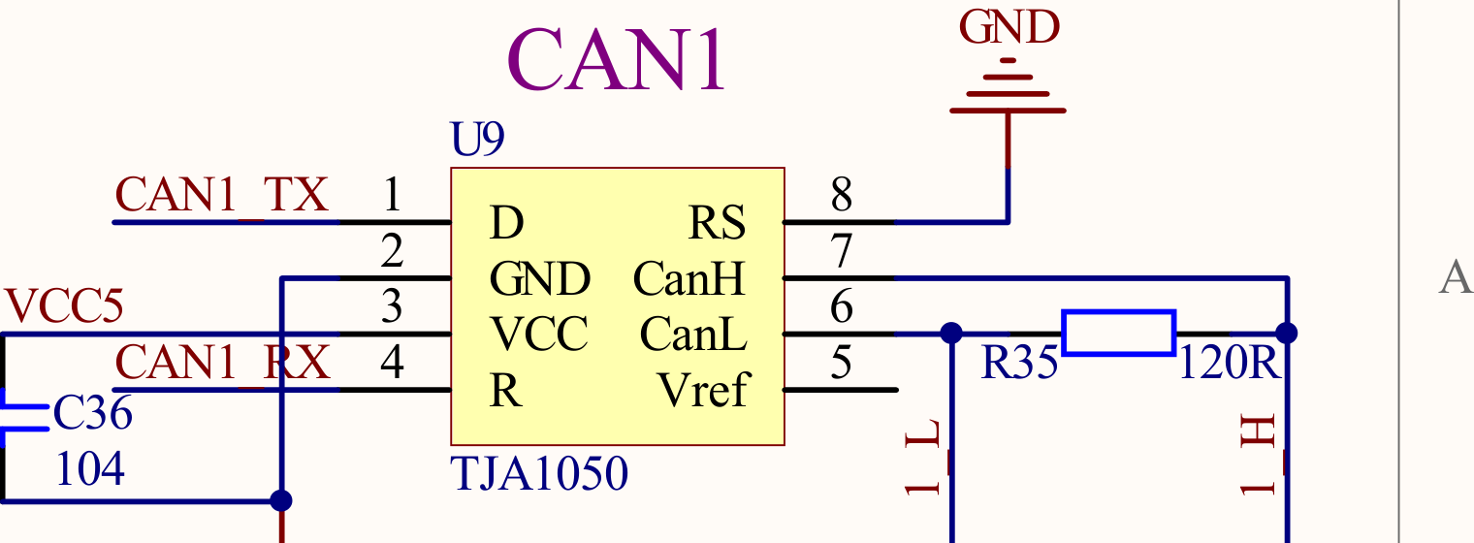
docs/sch/can1_term.png
