741-xiao/stm32f407-dual-board-ai/docs/sch/can2_iopins.png

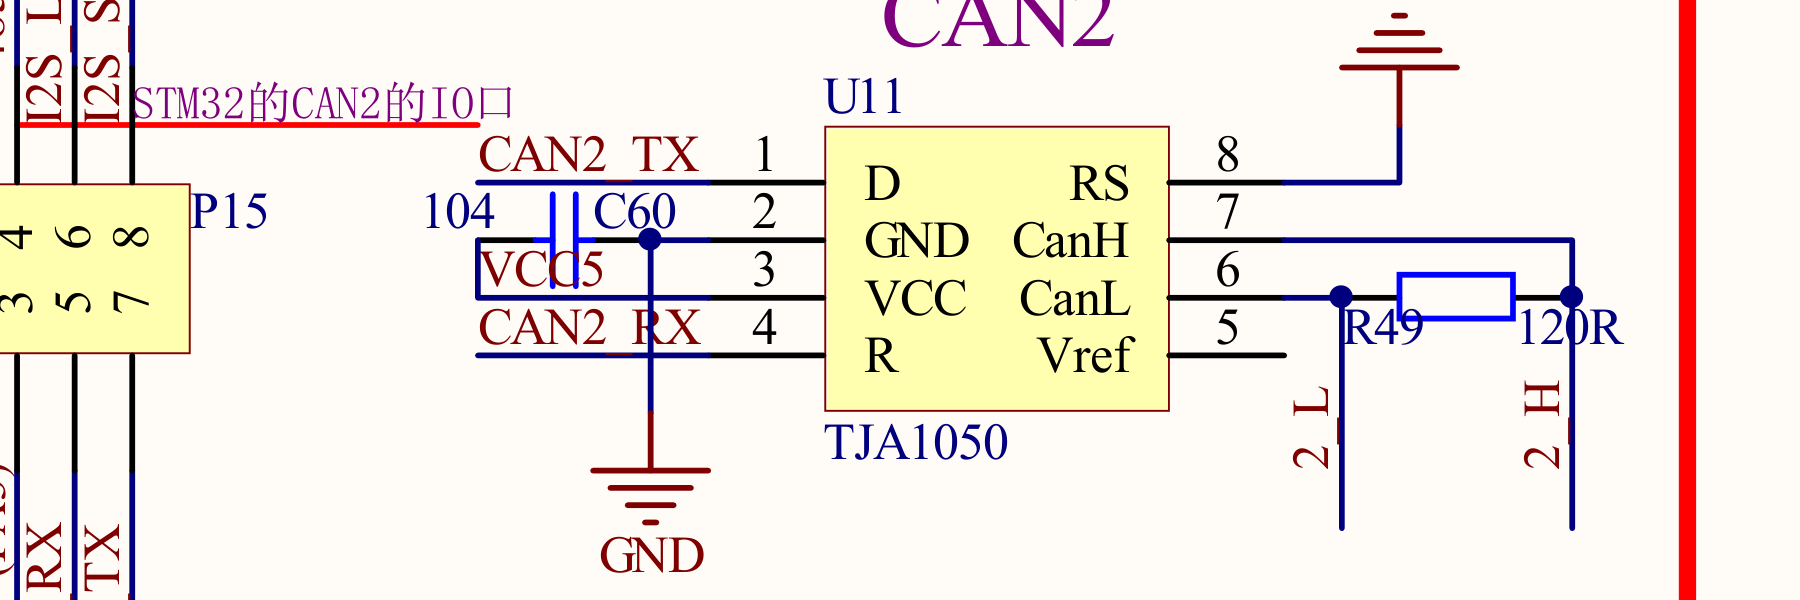
docs/sch/can2_iopins.png
