741-xiao/stm32f407-dual-board-ai/docs/sch/iic_area.png

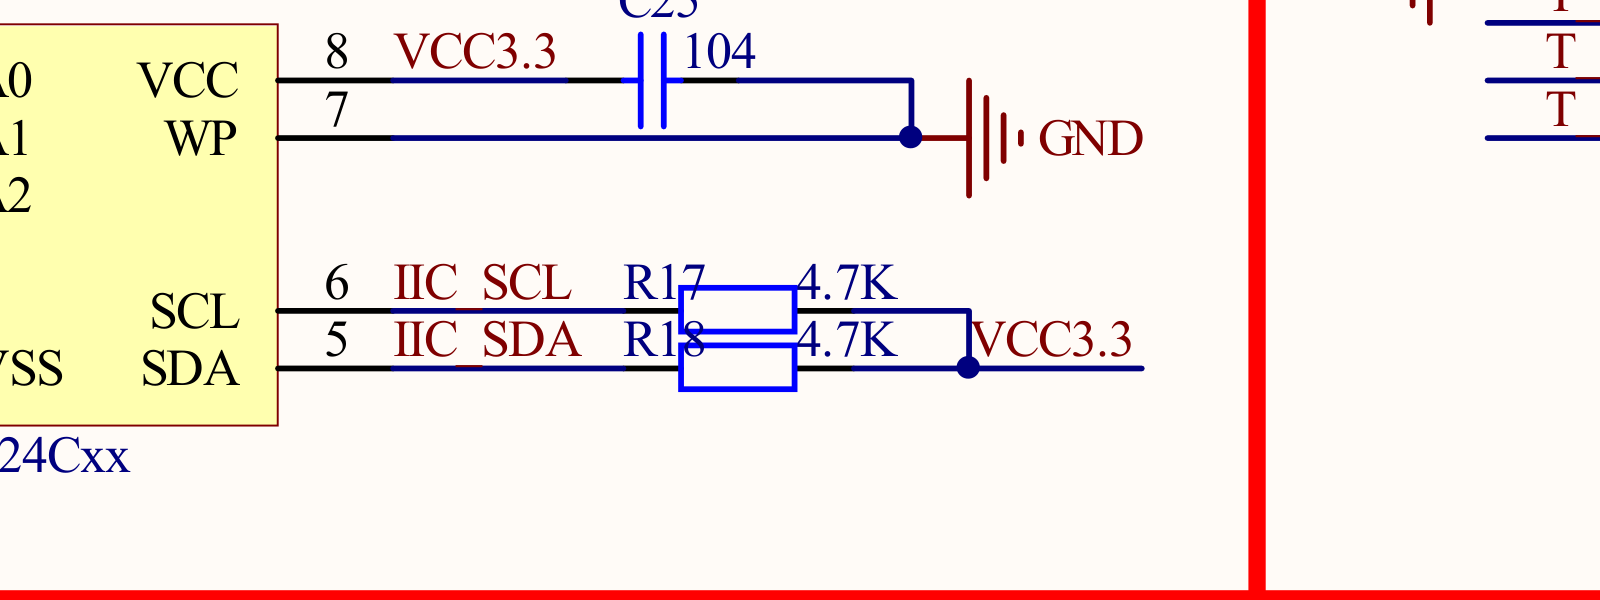
docs/sch/iic_area.png
