741-xiao/stm32f407-dual-board-ai/docs/sch/lcd_conn.png

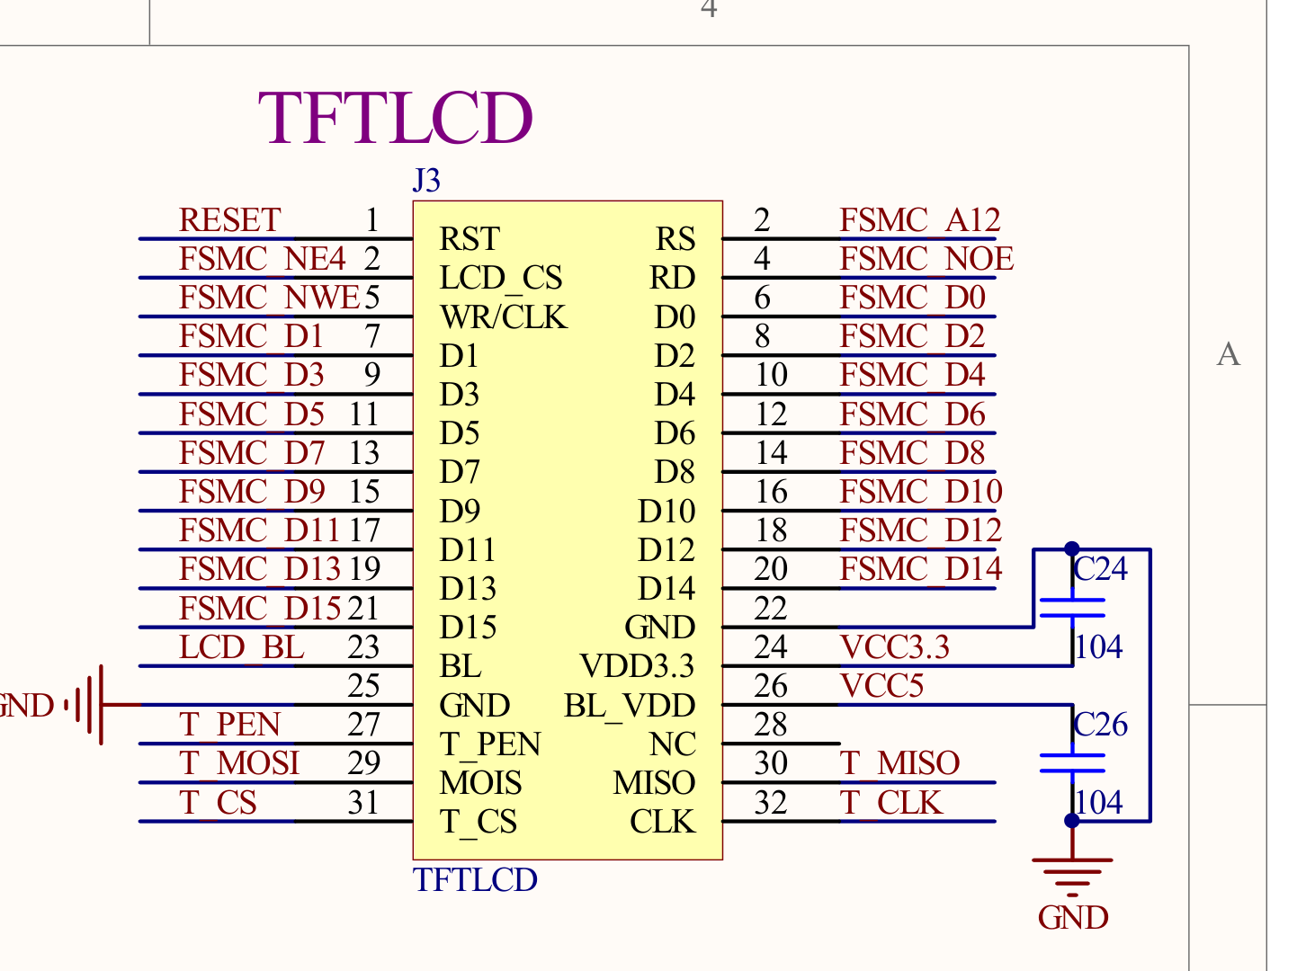
docs/sch/lcd_conn.png
