741-xiao/stm32f407-dual-board-ai/docs/sch/mcu_pa11_12.png

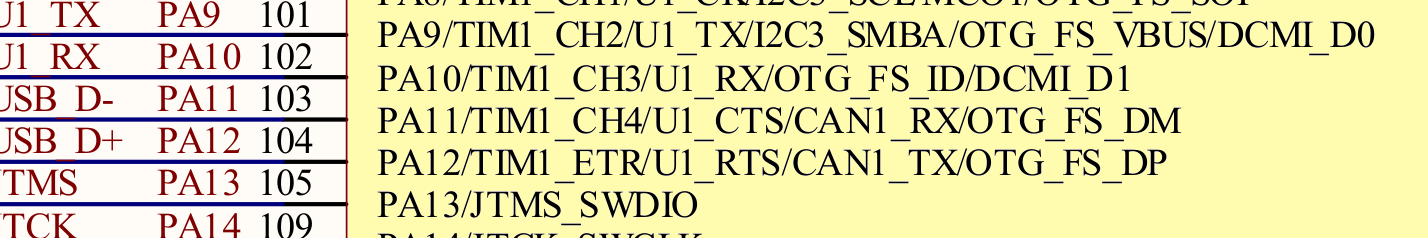
docs/sch/mcu_pa11_12.png
