741-xiao/stm32f407-dual-board-ai/docs/sch/p21_zoom.png

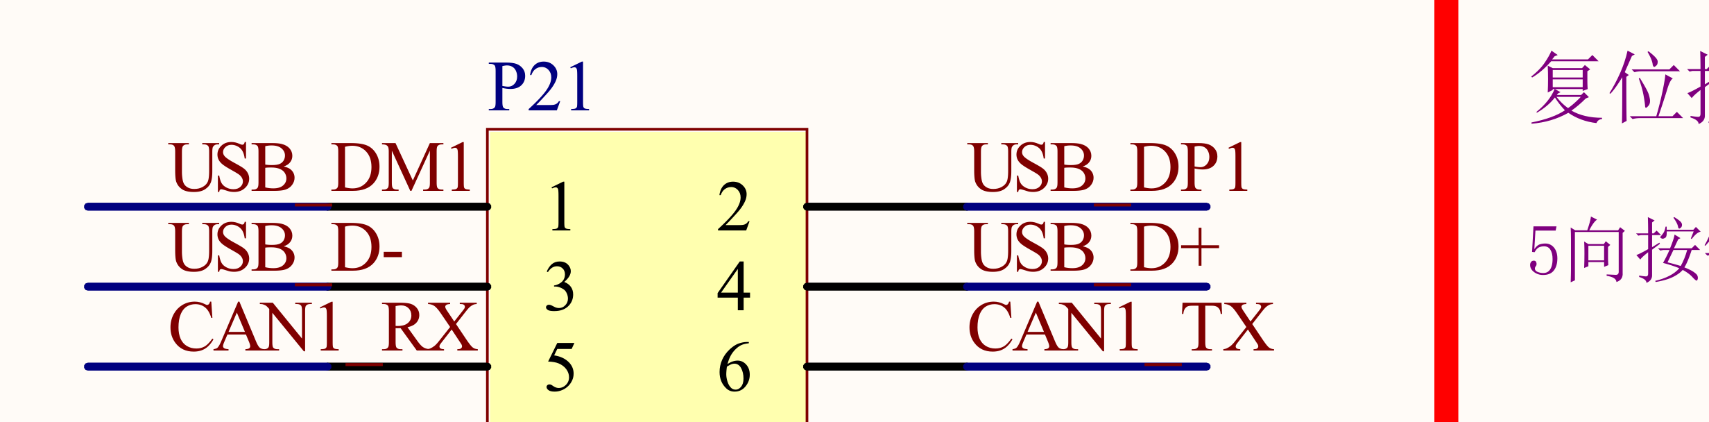
docs/sch/p21_zoom.png
