741-xiao/stm32f407-dual-board-ai/docs/sch/page3_overview.png

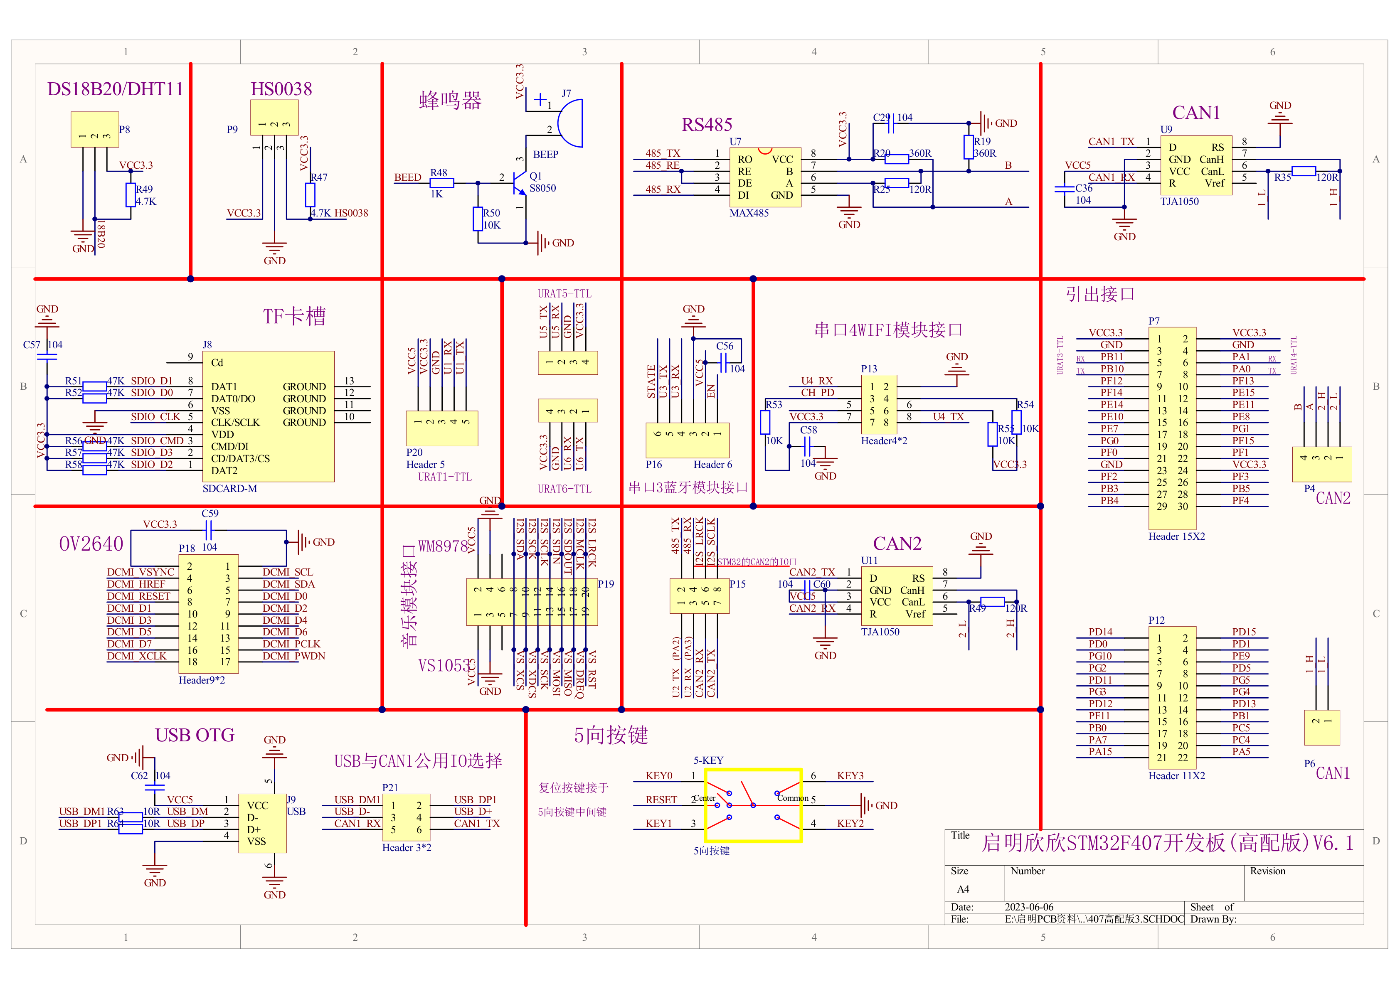
docs/sch/page3_overview.png
