741-xiao/stm32f407-dual-board-ai/docs/sch/pb5_pb9_label.png

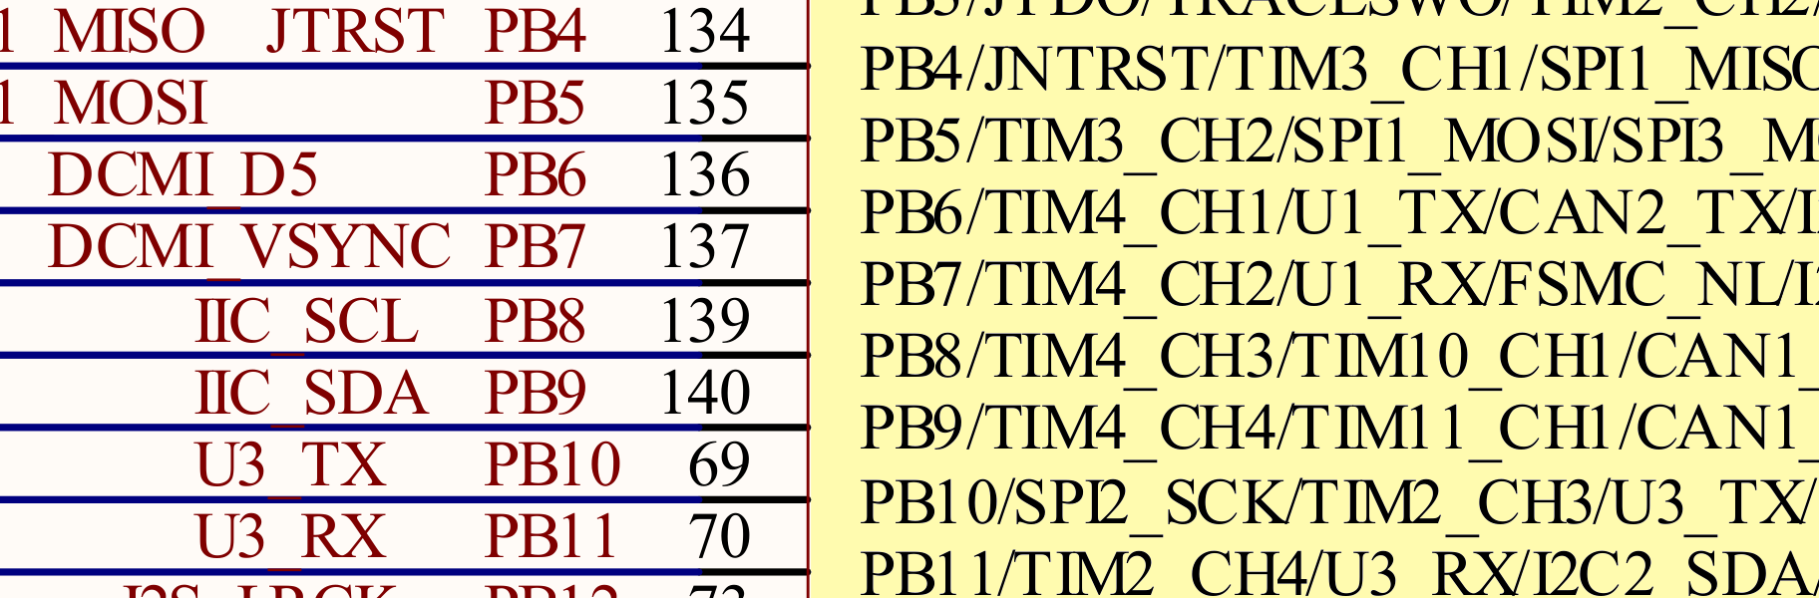
docs/sch/pb5_pb9_label.png
