741-xiao/stm32f407-dual-board-ai/docs/sch/sch_can_rs485.png

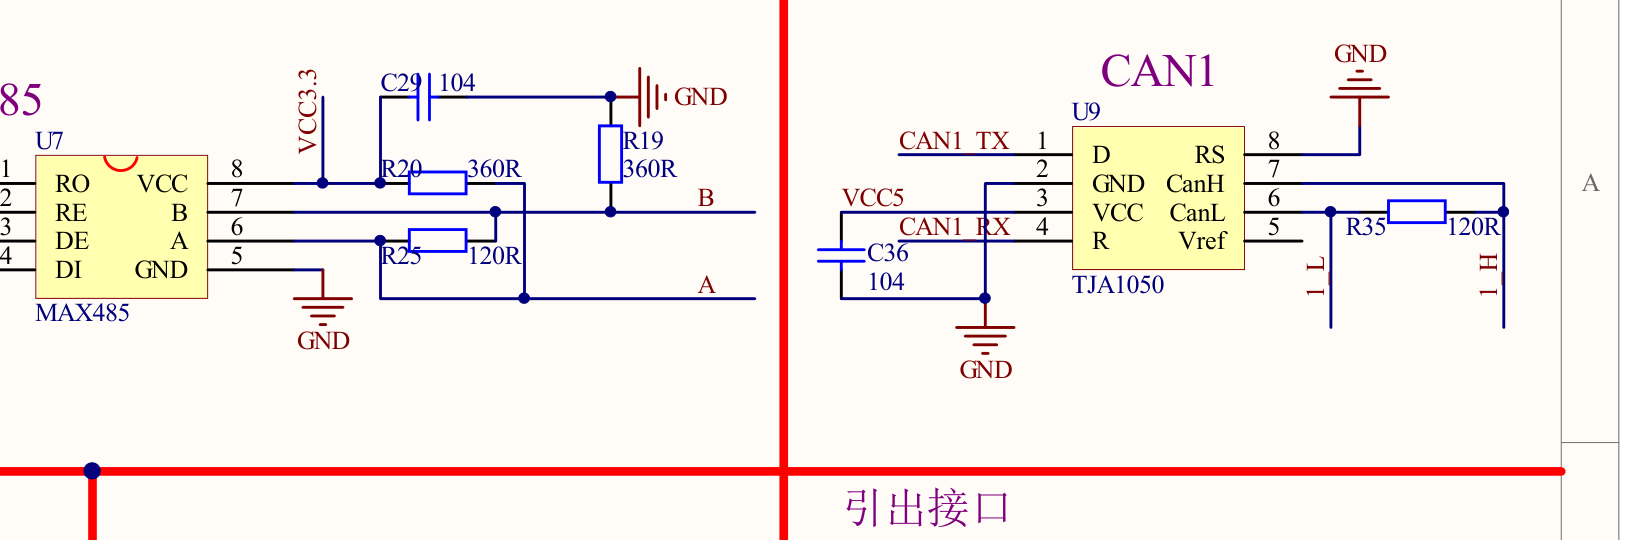
docs/sch/sch_can_rs485.png
