741-xiao/stm32f407-dual-board-ai/docs/sch/sch_key.png

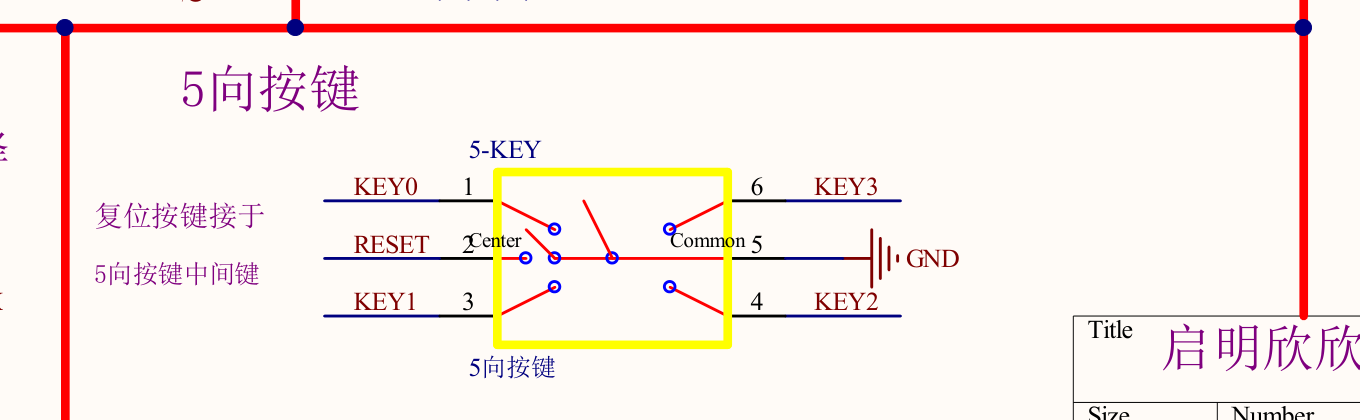
docs/sch/sch_key.png
