741-xiao/stm32f407-dual-board-ai/docs/sch/sch_wifi_esp.png

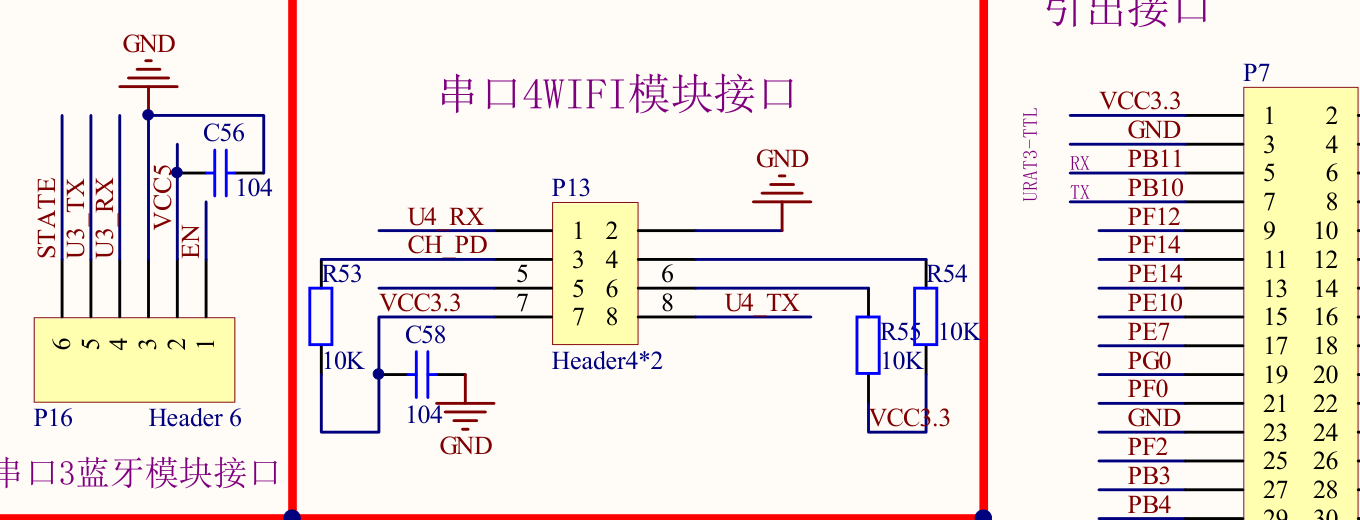
docs/sch/sch_wifi_esp.png
