741-xiao/stm32f407-dual-board-ai/docs/sch/usb_can_jumper.png

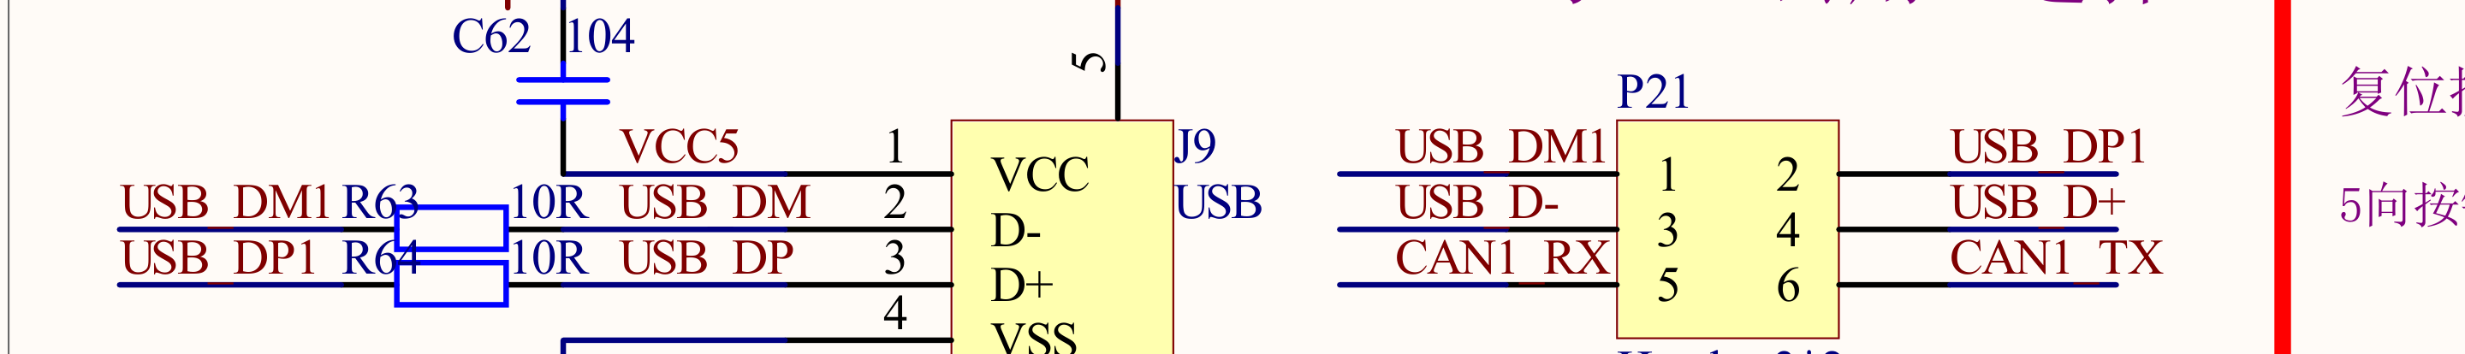
docs/sch/usb_can_jumper.png
