741-xiao/stm32f407-dual-board-ai/docs/sch/wifi_socket.png

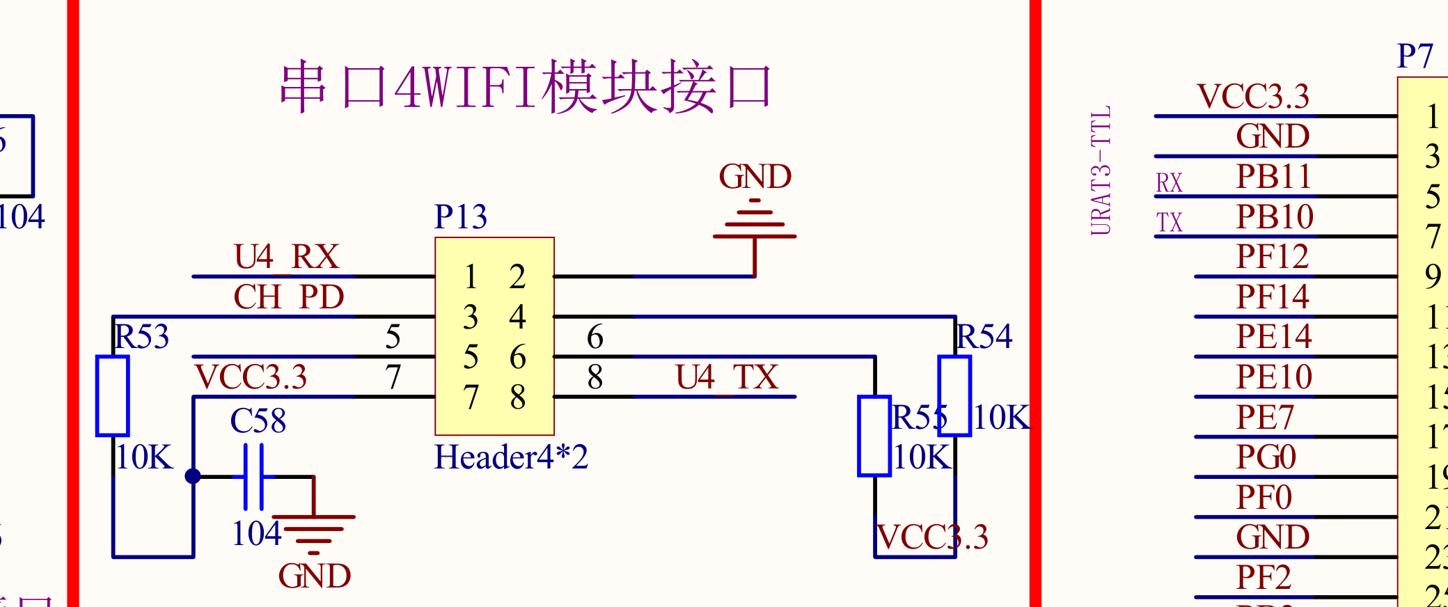
docs/sch/wifi_socket.png
