741-xiao/stm32f407-dual-board-ai/firmware/Core/Src/fsmc.c

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

/* Includes ------------------------------------------------------------------*/
#include "fsmc.h"

SRAM_HandleTypeDef hsram1;

/* FSMC initialization function */
void MX_FSMC_Init(void)
{
  FSMC_NORSRAM_TimingTypeDef Timing = {0};
  FSMC_NORSRAM_TimingTypeDef ExtTiming = {0};

  /** Perform the SRAM1 memory initialization sequence
  */
  hsram1.Instance = FSMC_NORSRAM_DEVICE;
  hsram1.Extended = FSMC_NORSRAM_EXTENDED_DEVICE;
  /* hsram1.Init */
  hsram1.Init.NSBank = FSMC_NORSRAM_BANK4;
  hsram1.Init.DataAddressMux = FSMC_DATA_ADDRESS_MUX_DISABLE;
  hsram1.Init.MemoryType = FSMC_MEMORY_TYPE_SRAM;
  hsram1.Init.MemoryDataWidth = FSMC_NORSRAM_MEM_BUS_WIDTH_16;
  hsram1.Init.BurstAccessMode = FSMC_BURST_ACCESS_MODE_DISABLE;
  hsram1.Init.WaitSignalPolarity = FSMC_WAIT_SIGNAL_POLARITY_LOW;
  hsram1.Init.WrapMode = FSMC_WRAP_MODE_DISABLE;
  hsram1.Init.WaitSignalActive = FSMC_WAIT_TIMING_BEFORE_WS;
  hsram1.Init.WriteOperation = FSMC_WRITE_OPERATION_ENABLE;
  hsram1.Init.WaitSignal = FSMC_WAIT_SIGNAL_DISABLE;
  hsram1.Init.ExtendedMode = FSMC_EXTENDED_MODE_ENABLE;
  hsram1.Init.AsynchronousWait = FSMC_ASYNCHRONOUS_WAIT_DISABLE;
  hsram1.Init.WriteBurst = FSMC_WRITE_BURST_DISABLE;
  hsram1.Init.PageSize = FSMC_PAGE_SIZE_NONE;
  /* Timing */
  Timing.AddressSetupTime = 15;
  Timing.AddressHoldTime = 0;
  Timing.DataSetupTime = 60;
  Timing.BusTurnAroundDuration = 0;
  Timing.CLKDivision = 16;
  Timing.DataLatency = 17;
  Timing.AccessMode = FSMC_ACCESS_MODE_A;
  /* ExtTiming */
  ExtTiming.AddressSetupTime = 9;
  ExtTiming.AddressHoldTime = 0;
  ExtTiming.DataSetupTime = 8;
  ExtTiming.BusTurnAroundDuration = 0;
  ExtTiming.CLKDivision = 16;
  ExtTiming.DataLatency = 17;
  ExtTiming.AccessMode = FSMC_ACCESS_MODE_A;

  if (HAL_SRAM_Init(&hsram1, &Timing, &ExtTiming) != HAL_OK)
  {
    Error_Handler( );
  }

}

static uint32_t FSMC_Initialized = 0;

static void HAL_FSMC_MspInit(void){
  GPIO_InitTypeDef GPIO_InitStruct = {0};
  if (FSMC_Initialized) {
    return;
  }
  FSMC_Initialized = 1;

  /* Peripheral clock enable */
  __HAL_RCC_FSMC_CLK_ENABLE();

  /** FSMC GPIO Configuration
  PE7   ------> FSMC_D4
  PE8   ------> FSMC_D5
  PE9   ------> FSMC_D6
  PE10   ------> FSMC_D7
  PE11   ------> FSMC_D8
  PE12   ------> FSMC_D9
  PE13   ------> FSMC_D10
  PE14   ------> FSMC_D11
  PE15   ------> FSMC_D12
  PD8   ------> FSMC_D13
  PD9   ------> FSMC_D14
  PD10   ------> FSMC_D15
  PD14   ------> FSMC_D0
  PD15   ------> FSMC_D1
  PG2   ------> FSMC_A12
  PD0   ------> FSMC_D2
  PD1   ------> FSMC_D3
  PD4   ------> FSMC_NOE
  PD5   ------> FSMC_NWE
  PG12   ------> FSMC_NE4
  */
  /* GPIO_InitStruct */
  GPIO_InitStruct.Pin = GPIO_PIN_7|GPIO_PIN_8|GPIO_PIN_9|GPIO_PIN_10
                          |GPIO_PIN_11|GPIO_PIN_12|GPIO_PIN_13|GPIO_PIN_14
                          |GPIO_PIN_15;
  GPIO_InitStruct.Mode = GPIO_MODE_AF_PP;
  GPIO_InitStruct.Pull = GPIO_NOPULL;
  GPIO_InitStruct.Speed = GPIO_SPEED_FREQ_VERY_HIGH;
  GPIO_InitStruct.Alternate = GPIO_AF12_FSMC;

  HAL_GPIO_Init(GPIOE, &GPIO_InitStruct);

  /* GPIO_InitStruct */
  GPIO_InitStruct.Pin = GPIO_PIN_8|GPIO_PIN_9|GPIO_PIN_10|GPIO_PIN_14
                          |GPIO_PIN_15|GPIO_PIN_0|GPIO_PIN_1|GPIO_PIN_4
                          |GPIO_PIN_5;
  GPIO_InitStruct.Mode = GPIO_MODE_AF_PP;
  GPIO_InitStruct.Pull = GPIO_NOPULL;
  GPIO_InitStruct.Speed = GPIO_SPEED_FREQ_VERY_HIGH;
  GPIO_InitStruct.Alternate = GPIO_AF12_FSMC;

  HAL_GPIO_Init(GPIOD, &GPIO_InitStruct);

  /* GPIO_InitStruct */
  GPIO_InitStruct.Pin = GPIO_PIN_2|GPIO_PIN_12;
  GPIO_InitStruct.Mode = GPIO_MODE_AF_PP;
  GPIO_InitStruct.Pull = GPIO_NOPULL;
  GPIO_InitStruct.Speed = GPIO_SPEED_FREQ_VERY_HIGH;
  GPIO_InitStruct.Alternate = GPIO_AF12_FSMC;

  HAL_GPIO_Init(GPIOG, &GPIO_InitStruct);

  /* USER CODE BEGIN FSMC_MspInit 1 */
  /* CubeMX 默认把 FSMC 引脚配成 GPIO_NOPULL（悬空）。实验2 里同样的引脚配的是
     GPIO_PULLUP，数据总线悬空会导致读回全 0（读不到 LCD ID）。这里按实验2 补回上拉。
     写在 USER CODE 段里，重新生成代码也不会丢。*/
  {
    GPIO_InitTypeDef gpio_fsmc_pull = {0};

    gpio_fsmc_pull.Mode      = GPIO_MODE_AF_PP;
    gpio_fsmc_pull.Pull      = GPIO_PULLUP;
    gpio_fsmc_pull.Speed     = GPIO_SPEED_FREQ_VERY_HIGH;
    gpio_fsmc_pull.Alternate = GPIO_AF12_FSMC;

    gpio_fsmc_pull.Pin = GPIO_PIN_7|GPIO_PIN_8|GPIO_PIN_9|GPIO_PIN_10
                       |GPIO_PIN_11|GPIO_PIN_12|GPIO_PIN_13|GPIO_PIN_14
                       |GPIO_PIN_15;
    HAL_GPIO_Init(GPIOE, &gpio_fsmc_pull);

    gpio_fsmc_pull.Pin = GPIO_PIN_8|GPIO_PIN_9|GPIO_PIN_10|GPIO_PIN_14
                       |GPIO_PIN_15|GPIO_PIN_0|GPIO_PIN_1|GPIO_PIN_4
                       |GPIO_PIN_5;
    HAL_GPIO_Init(GPIOD, &gpio_fsmc_pull);

    gpio_fsmc_pull.Pin = GPIO_PIN_2|GPIO_PIN_12;
    HAL_GPIO_Init(GPIOG, &gpio_fsmc_pull);
  }
  /* USER CODE END FSMC_MspInit 1 */
}

void HAL_SRAM_MspInit(SRAM_HandleTypeDef* sramHandle){
  HAL_FSMC_MspInit();
}

static uint32_t FSMC_DeInitialized = 0;

static void HAL_FSMC_MspDeInit(void){
  if (FSMC_DeInitialized) {
    return;
  }
  FSMC_DeInitialized = 1;
  /* Peripheral clock enable */
  __HAL_RCC_FSMC_CLK_DISABLE();

  /** FSMC GPIO Configuration
  PE7   ------> FSMC_D4
  PE8   ------> FSMC_D5
  PE9   ------> FSMC_D6
  PE10   ------> FSMC_D7
  PE11   ------> FSMC_D8
  PE12   ------> FSMC_D9
  PE13   ------> FSMC_D10
  PE14   ------> FSMC_D11
  PE15   ------> FSMC_D12
  PD8   ------> FSMC_D13
  PD9   ------> FSMC_D14
  PD10   ------> FSMC_D15
  PD14   ------> FSMC_D0
  PD15   ------> FSMC_D1
  PG2   ------> FSMC_A12
  PD0   ------> FSMC_D2
  PD1   ------> FSMC_D3
  PD4   ------> FSMC_NOE
  PD5   ------> FSMC_NWE
  PG12   ------> FSMC_NE4
  */

  HAL_GPIO_DeInit(GPIOE, GPIO_PIN_7|GPIO_PIN_8|GPIO_PIN_9|GPIO_PIN_10
                          |GPIO_PIN_11|GPIO_PIN_12|GPIO_PIN_13|GPIO_PIN_14
                          |GPIO_PIN_15);

  HAL_GPIO_DeInit(GPIOD, GPIO_PIN_8|GPIO_PIN_9|GPIO_PIN_10|GPIO_PIN_14
                          |GPIO_PIN_15|GPIO_PIN_0|GPIO_PIN_1|GPIO_PIN_4
                          |GPIO_PIN_5);

  HAL_GPIO_DeInit(GPIOG, GPIO_PIN_2|GPIO_PIN_12);

}

void HAL_SRAM_MspDeInit(SRAM_HandleTypeDef* sramHandle){
  HAL_FSMC_MspDeInit();
}
/**
  * @}
  */

/**
  * @}
  */
