741-xiao/stm32f407-dual-board-ai/firmware/USER/App/app_text.h

/*==============================================================================
 *  app_text.h  ---  串口/网络输出用的中文字符串（GB18030 编码）
 *
 *  为什么不做成普通 C 字符串字面量：
 *    工程源文件是 UTF-8，ARMCC 遇到字符串里的多字节 UTF-8 会报
 *    "#870-D: invalid multibyte character sequence"。改成 GB18030 字节数组：
 *      1) 源文件里只剩 0xNN 的 ASCII 字符，编译安静通过；
 *      2) Windows 串口助手默认按 GBK/ANSI 解码，正好显示成中文；
 *      3) 上位机 Python 用 data.decode("gbk") 也能还原中文。
 *
 *  大部分条目由脚本生成；TXT_NAME_PRE / TXT_ID_PRE / TXT_EOL 是手写的，
 *  配合 app_id.h 一起用。
 *============================================================================*/
#ifndef __APP_TEXT_H
#define __APP_TEXT_H

#include "common.h"

/* ======== STM32F407ZG 实验三 温湿度采集 ======== */
static const u8 TXT_BOOT1[] = {0x3D,0x3D,0x3D,0x3D,0x3D,0x3D,0x3D,0x3D,0x20,0x53,0x54,0x4D,0x33,0x32,0x46,0x34,0x30,0x37,0x5A,0x47,0x20,0xCA,0xB5,0xD1,0xE9,0xC8,0xFD,0x20,0xCE,0xC2,0xCA,0xAA,0xB6,0xC8,0xB2,0xC9,0xBC,0xAF,0x20,0x3D,0x3D,0x3D,0x3D,0x3D,0x3D,0x3D,0x3D,0x0D,0x0A,0x00};

/* 开机横幅的姓名/学号拆成三段，中间夹真实值（值在 app_id.h）。
   拼出来是：姓名: <姓名>            学号: <STU_ID> CR LF */
/* 姓名:  */
static const u8 TXT_NAME_PRE[] = {0xD0,0xD5,0xC3,0xFB,0x3A,0x20,0x00};

/* 12 个空格 + 学号:  */
static const u8 TXT_ID_PRE[] = {0x20,0x20,0x20,0x20,0x20,0x20,0x20,0x20,0x20,0x20,0x20,0x20,0xD1,0xA7,0xBA,0xC5,0x3A,0x20,0x00};

/* CR LF */
static const u8 TXT_EOL[] = {0x0D,0x0A,0x00};

/* 按键1: 开始采集 */
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

/* [数据] %04u 传感器读取失败 状态:错误 */
static const u8 TXT_FAIL6[] = {0x5B,0xCA,0xFD,0xBE,0xDD,0x5D,0x20,0x25,0x30,0x34,0x75,0x20,0xB4,0xAB,0xB8,0xD0,0xC6,0xF7,0xB6,0xC1,0xC8,0xA1,0xCA,0xA7,0xB0,0xDC,0x20,0xD7,0xB4,0xCC,0xAC,0x3A,0xB4,0xED,0xCE,0xF3,0x00};

/* 实验七 · 两块板 CAN 组网 · 温湿度/光敏/SGP30(CO2+VOC) */
static const u8 TXT_BOOT6[] = {0xCA,0xB5,0xD1,0xE9,0xC6,0xDF,0x20,0xA1,0xA4,0x20,0xC1,0xBD,0xBF,0xE9,0xB0,0xE5,0x20,0x43,0x41,0x4E,0x20,0xD7,0xE9,0xCD,0xF8,0x20,0xA1,0xA4,0x20,0xCE,0xC2,0xCA,0xAA,0xB6,0xC8,0x2F,0xB9,0xE2,0xC3,0xF4,0x2F,0x53,0x47,0x50,0x33,0x30,0x28,0x43,0x4F,0x32,0x2B,0x56,0x4F,0x43,0x29,0x00};

#endif
