741-xiao/stm32f407-dual-board-ai/firmware/Core/Src/i2c.c

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
/* Includes ------------------------------------------------------------------*/
#include "i2c.h"

I2C_HandleTypeDef hi2c1;
I2C_HandleTypeDef hi2c2;

/* I2C1 init function */
void MX_I2C1_Init(void)
{

  hi2c1.Instance = I2C1;
  hi2c1.Init.ClockSpeed = 100000;
  hi2c1.Init.DutyCycle = I2C_DUTYCYCLE_2;
  hi2c1.Init.OwnAddress1 = 0;
  hi2c1.Init.AddressingMode = I2C_ADDRESSINGMODE_7BIT;
  hi2c1.Init.DualAddressMode = I2C_DUALADDRESS_DISABLE;
  hi2c1.Init.OwnAddress2 = 0;
  hi2c1.Init.GeneralCallMode = I2C_GENERALCALL_DISABLE;
  hi2c1.Init.NoStretchMode = I2C_NOSTRETCH_DISABLE;
  if (HAL_I2C_Init(&hi2c1) != HAL_OK)
  {
    Error_Handler();
  }
}
/* I2C2 init function */
void MX_I2C2_Init(void)
{

  hi2c2.Instance = I2C2;
  hi2c2.Init.ClockSpeed = 100000;
  hi2c2.Init.DutyCycle = I2C_DUTYCYCLE_2;
  hi2c2.Init.OwnAddress1 = 0;
  hi2c2.Init.AddressingMode = I2C_ADDRESSINGMODE_7BIT;
  hi2c2.Init.DualAddressMode = I2C_DUALADDRESS_DISABLE;
  hi2c2.Init.OwnAddress2 = 0;
  hi2c2.Init.GeneralCallMode = I2C_GENERALCALL_DISABLE;
  hi2c2.Init.NoStretchMode = I2C_NOSTRETCH_DISABLE;
  if (HAL_I2C_Init(&hi2c2) != HAL_OK)
  {
    Error_Handler();
  }
}

void HAL_I2C_MspInit(I2C_HandleTypeDef* i2cHandle)
{

  GPIO_InitTypeDef GPIO_InitStruct = {0};
  if(i2cHandle->Instance==I2C1)
  {
    __HAL_RCC_GPIOB_CLK_ENABLE();
    /**I2C1 GPIO Configuration
    PB6     ------> I2C1_SCL
    PB7     ------> I2C1_SDA
    */
    GPIO_InitStruct.Pin = GPIO_PIN_6|GPIO_PIN_7;
    GPIO_InitStruct.Mode = GPIO_MODE_AF_OD;
    GPIO_InitStruct.Pull = GPIO_NOPULL;
    GPIO_InitStruct.Speed = GPIO_SPEED_FREQ_VERY_HIGH;
    GPIO_InitStruct.Alternate = GPIO_AF4_I2C1;
    HAL_GPIO_Init(GPIOB, &GPIO_InitStruct);

    /* I2C1 clock enable */
    __HAL_RCC_I2C1_CLK_ENABLE();
  /* USER CODE BEGIN I2C1_MspInit 1 */
  /* CubeMX 对 I2C 引脚默认不给上拉，这里补上内部上拉（约 40kΩ）。
   * I2C 是开漏总线，必须有上拉才能把 SCL/SDA 拉高。
   * SHT30 模块若自带上拉电阻，这里再开内部上拉也无害；
   * 若是裸传感器，则还需要外部 4.7k~10k 上拉到 3.3V 才能稳定通信。 */
  {
    GPIO_InitTypeDef i2c_pull_up = {0};

    i2c_pull_up.Pin       = GPIO_PIN_6 | GPIO_PIN_7;
    i2c_pull_up.Mode      = GPIO_MODE_AF_OD;
    i2c_pull_up.Pull      = GPIO_PULLUP;
    i2c_pull_up.Speed     = GPIO_SPEED_FREQ_VERY_HIGH;
    i2c_pull_up.Alternate = GPIO_AF4_I2C1;
    HAL_GPIO_Init(GPIOB, &i2c_pull_up);
  }
  /* USER CODE END I2C1_MspInit 1 */
  }
  else if(i2cHandle->Instance==I2C2)
  {
    __HAL_RCC_GPIOF_CLK_ENABLE();
    /**I2C2 GPIO Configuration
    PF0     ------> I2C2_SDA
    PF1     ------> I2C2_SCL
    */
    GPIO_InitStruct.Pin = GPIO_PIN_0|GPIO_PIN_1;
    GPIO_InitStruct.Mode = GPIO_MODE_AF_OD;
    GPIO_InitStruct.Pull = GPIO_NOPULL;
    GPIO_InitStruct.Speed = GPIO_SPEED_FREQ_VERY_HIGH;
    GPIO_InitStruct.Alternate = GPIO_AF4_I2C2;
    HAL_GPIO_Init(GPIOF, &GPIO_InitStruct);

    /* I2C2 clock enable */
    __HAL_RCC_I2C2_CLK_ENABLE();
  /* USER CODE BEGIN I2C2_MspInit 1 */
  /* 与 I2C1 同样处理：CubeMX 默认不给 I2C 引脚上拉，这里补内部上拉（约 40kΩ）。
   * I2C2 接 SGP30（PB10/PB11 那条是备选；本板 CubeMX 选的是 PF0= SDA / PF1=SCL）。
   * SGP30 模块若自带上拉，这里再开也无害；裸传感器则需外部 4.7k~10k 上拉到 3.3V。 */
  {
    GPIO_InitTypeDef i2c2_pull_up = {0};

    i2c2_pull_up.Pin       = GPIO_PIN_0 | GPIO_PIN_1;
    i2c2_pull_up.Mode      = GPIO_MODE_AF_OD;
    i2c2_pull_up.Pull      = GPIO_PULLUP;
    i2c2_pull_up.Speed     = GPIO_SPEED_FREQ_VERY_HIGH;
    i2c2_pull_up.Alternate = GPIO_AF4_I2C2;
    HAL_GPIO_Init(GPIOF, &i2c2_pull_up);
  }
  /* USER CODE END I2C2_MspInit 1 */
  }
}

void HAL_I2C_MspDeInit(I2C_HandleTypeDef* i2cHandle)
{

  if(i2cHandle->Instance==I2C1)
  {
    /* Peripheral clock disable */
    __HAL_RCC_I2C1_CLK_DISABLE();

    /**I2C1 GPIO Configuration
    PB6     ------> I2C1_SCL
    PB7     ------> I2C1_SDA
    */
    HAL_GPIO_DeInit(GPIOB, GPIO_PIN_6);

    HAL_GPIO_DeInit(GPIOB, GPIO_PIN_7);

  }
  else if(i2cHandle->Instance==I2C2)
  {
    /* Peripheral clock disable */
    __HAL_RCC_I2C2_CLK_DISABLE();

    /**I2C2 GPIO Configuration
    PF0     ------> I2C2_SDA
    PF1     ------> I2C2_SCL
    */
    HAL_GPIO_DeInit(GPIOF, GPIO_PIN_0);

    HAL_GPIO_DeInit(GPIOF, GPIO_PIN_1);

  }
}
