741-xiao/stm32f407-dual-board-ai/firmware/USER/WIFI/esp01s.c

/*==============================================================================
 *  esp01s.c  ---  角色选择器（同 app.c 的套路）
 *
 *  ★ 实验六：三块板**全部是 TCP 客户端**（都主动连 PC 的 8080），
 *    板间数据改走 CAN，不再需要"板2 当服务器"那套。
 *    所以这里恒选 esp01s_client.c（原 esp01s_server.c 已删除）。
 *============================================================================*/
#include "common.h"
#include "esp01s.h"

#include "esp01s_client.c"
