741-xiao/stm32f407-dual-board-ai/(notices)

Notices in the files:
firmware/Core/Src/i2c.c:
Copyright (c) 2026 STMicroelectronics.
All rights reserved.
This software is licensed under terms that can be found in the LICENSE file
